ZacharyTurcotte/PMC-FrigorUS/README.md

# PMC-FrigorUS
code pour le projet de fin de bacc et les PCB
