ZacharyTurcotte/PMC-FrigorUS/PCB/Project Outputs for rasp_sheild/Report Board Stack/rasp_sheild.xls

Board Stack Report
Stack Up |  | Layer Stack
Layer | Board Layer Stack | Name | Material | Thickness | Constant
1 |  | Top Paste
2 |  | Top Overlay
3 |  | Top Solder | Solder Resist | 0.40mil | 3.5
4 |  | Top | Copper | 1.38mil
5 |  | Dielectric 3 |  | 62.99mil | 4.2
6 |  | Bottom | Copper | 1.38mil
7 |  | Bottom Solder | Solder Resist | 0.40mil | 3.5
8 |  | Bottom Overlay
9 |  | Bottom Paste
 | Height : 66.55mil
