ZacharyTurcotte/PMC-FrigorUS/PCB/Project Outputs for rasp_sheild/BOM/BOM-rasp_sheild.xlsx

Designator | Footprint | LibRef | Quantity | Value | Supplier Part Number 1
D2 | SMCJ36CA | SMCJ36CA | 1 |  | SMCJ36CABCT-ND
MH1, MH2, MH3, MH4 | MH2.75mm | MH2.75mm | 4
MH5, MH6, MH7 | MH3.2mm | MH3.2mm | 3
BT1 | 1058TR | 1058TR | 1 |  | 36-1058CT-ND
U5 | 8-SOIC | SN65HVD230QDR | 1 |  | 296-39176-1-ND
R1, R2, R3, R4, R5, R6, R7, R8, R9, R10, R11, R12, R13, R14, R15, R16, R17, R18, R19, R20, R21, R22, R23, R24, R25, R26, R27, R28, R29, R30, R31, R32, R33, R34, R35, R36, R37, R38, R39, R40, R41, R42, R43, R44, R45, R46, R47, R48, R49, R50, R51, R52, R53, R54, R55, R56, R57, R58, R59, R60 | RES_0603 | RES_0603 | 60 | 1k, 10k, 120 | 311-1.00KHRCT-ND
C3, C4, C5, C6, C7, C8, C9, C10, C11, C12, C14, C15, C16, C17, C18, C19, C20, C21, C22, C23, C24, C25, C26, C27, C28, C29 | CAP_0603 | CAP_0603 | 26 | 1uF, 0.1uF, 135pF, 22pF | 399-C0603C105K8RAC7867CT-ND
F1 | RES_0603 | F0603E1R75FSTR | 1 | 1.75A | 478-2865-1-ND
Y2 | ABLS-12.000MHZ-B4-T | ABLS-12.000MHZ-B4-T | 1 |  | 535-10218-1-ND
D1 | DO-214 | CDBA240LL-HF | 1 |  | 641-1698-6-ND
Y1 | SC32S-7PF20PPM | SC32S-7PF20PPM | 1 |  | 728-1074-1-ND
D5, D6, D7, D8 | LED 0603 | 150060SS75000 | 4 |  | 732-4979-1-ND
J4 | 61300311121 | 61300311121 | 1 |  | 732-5316-ND
J3, J6 | 691137710002 | 691137710002 | 2 |  | 732-10955-ND
C2, C13, C30 | CAP_0603 | CAP_0603 | 3 | 22uF, 0.1uF | 1276-1274-1-ND
C1 | CAP_1210 | CAP_1210 | 1 | 10uF | 1276-3387-1-ND
J1 | PRT-16764 | PRT-14275_1 | 1 |  | 1568-PRT-16764-ND
D4 | SOT-23-3 | PMEG2005CT,215 | 1 |  | 1727-5188-1-ND
PS1 | CONV_K7805-3AR3 | K7805-3AR3 | 1 |  | 2725-K7805-3AR3-ND
D3 | SOT-23-3 | PJEC12VM1TA-AU_R1_000A1 | 1 |  | 3757-PJEC12VM1TA-AU_R1_000A1DKR-ND
U1, U7, U8, U9 | D3V3F8U9LP3810-7 | D3V3F8U9LP3810-7 | 4 |  | D3V3F8U9LP3810-7DICT-ND
U2 | 24-QSSOP | MAX11625EEG+ | 1 |  | MAX11625EEG+-ND
U6 | 18-SOIC | MCP2515-I/SO | 1 |  | MCP2515-I/SO-ND
U3 | 28-SOIC | MCP23017T-E/SO | 1 |  | MCP23017T-E/SOCT-ND
U4 | 8-MSOP | PCA85073ADP/Q900Z | 1 |  | PCA85073ADP/Q900Z
J9 | 0430450400 | 0430450400 | 1 |  | WM1814-ND
J2, J5, J7, J8 | 0430451600 | 0430451600 | 4 |  | WM4724-ND
 |  |  | 11 |  | 311-10.0KHRCT-ND
 |  |  | 11 |  | P120DBCT-ND
 |  |  | 11 |  | 478-7939-1-ND
 |  |  | 11 |  | 399-15378-1-ND
