ZacharyTurcotte/PMC-FrigorUS/thermistance_arduino/python_read_serial/test_frigo.csv

N | Thermistor 0 | Thermistor 1 | Thermistor 2 | Thermistor 3 | Thermistor 4
0 | 18.86 | 16.05 | 14.46 | 13.66 | 22.74
1 | 19.65 | 17.02 | 15.43 | 14.64 | 22.74
2 | 19.74 | 17.02 | 15.26 | 14.28 | 22.74
3 | 19.48 | 16.67 | 14.99 | 14.19 | 22.74
4 | 19.83 | 17.20 | 15.61 | 14.72 | 22.74
5 | 19.65 | 16.84 | 15.08 | 14.10 | 22.74
6 | 19.48 | 16.84 | 15.26 | 14.46 | 22.74
7 | 19.83 | 17.28 | 15.61 | 14.64 | 22.74
8 | 19.48 | 16.76 | 14.99 | 14.01 | 22.65
9 | 19.65 | 17.11 | 15.52 | 14.72 | 22.65
