ZacharyTurcotte/PMC-FrigorUS/PCB/rasp_sheild.pdf

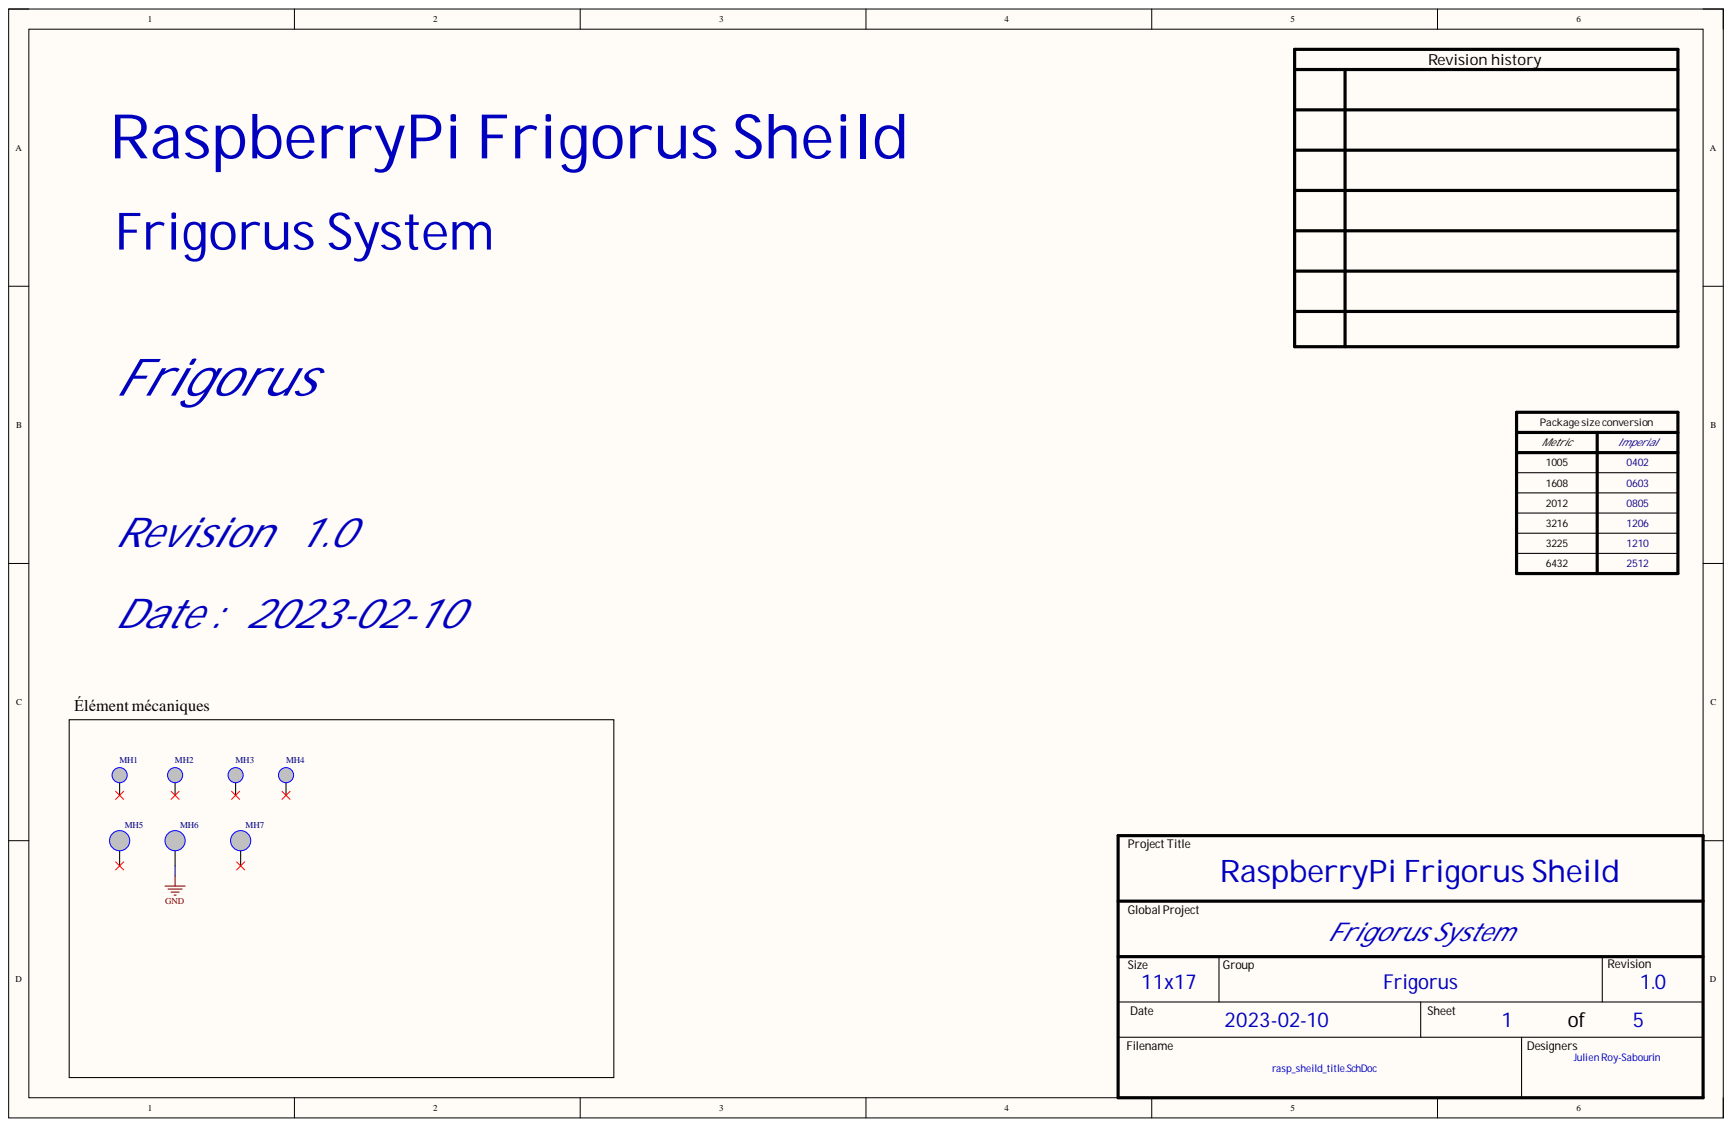
[picture p1: page 1]

Metric | Imperial
1005 | 0402
1608 | 0603
2012 | 0805
3216 | 1206
3225 | 1210
6432 | 2512

Size 11x17 | Group Frigorus | Revision 1.0

Date 2023-02-10 | Sheet of 1 5

Filename rasp_sheild_title.SchDoc | Designers Julien Roy-Sabourin

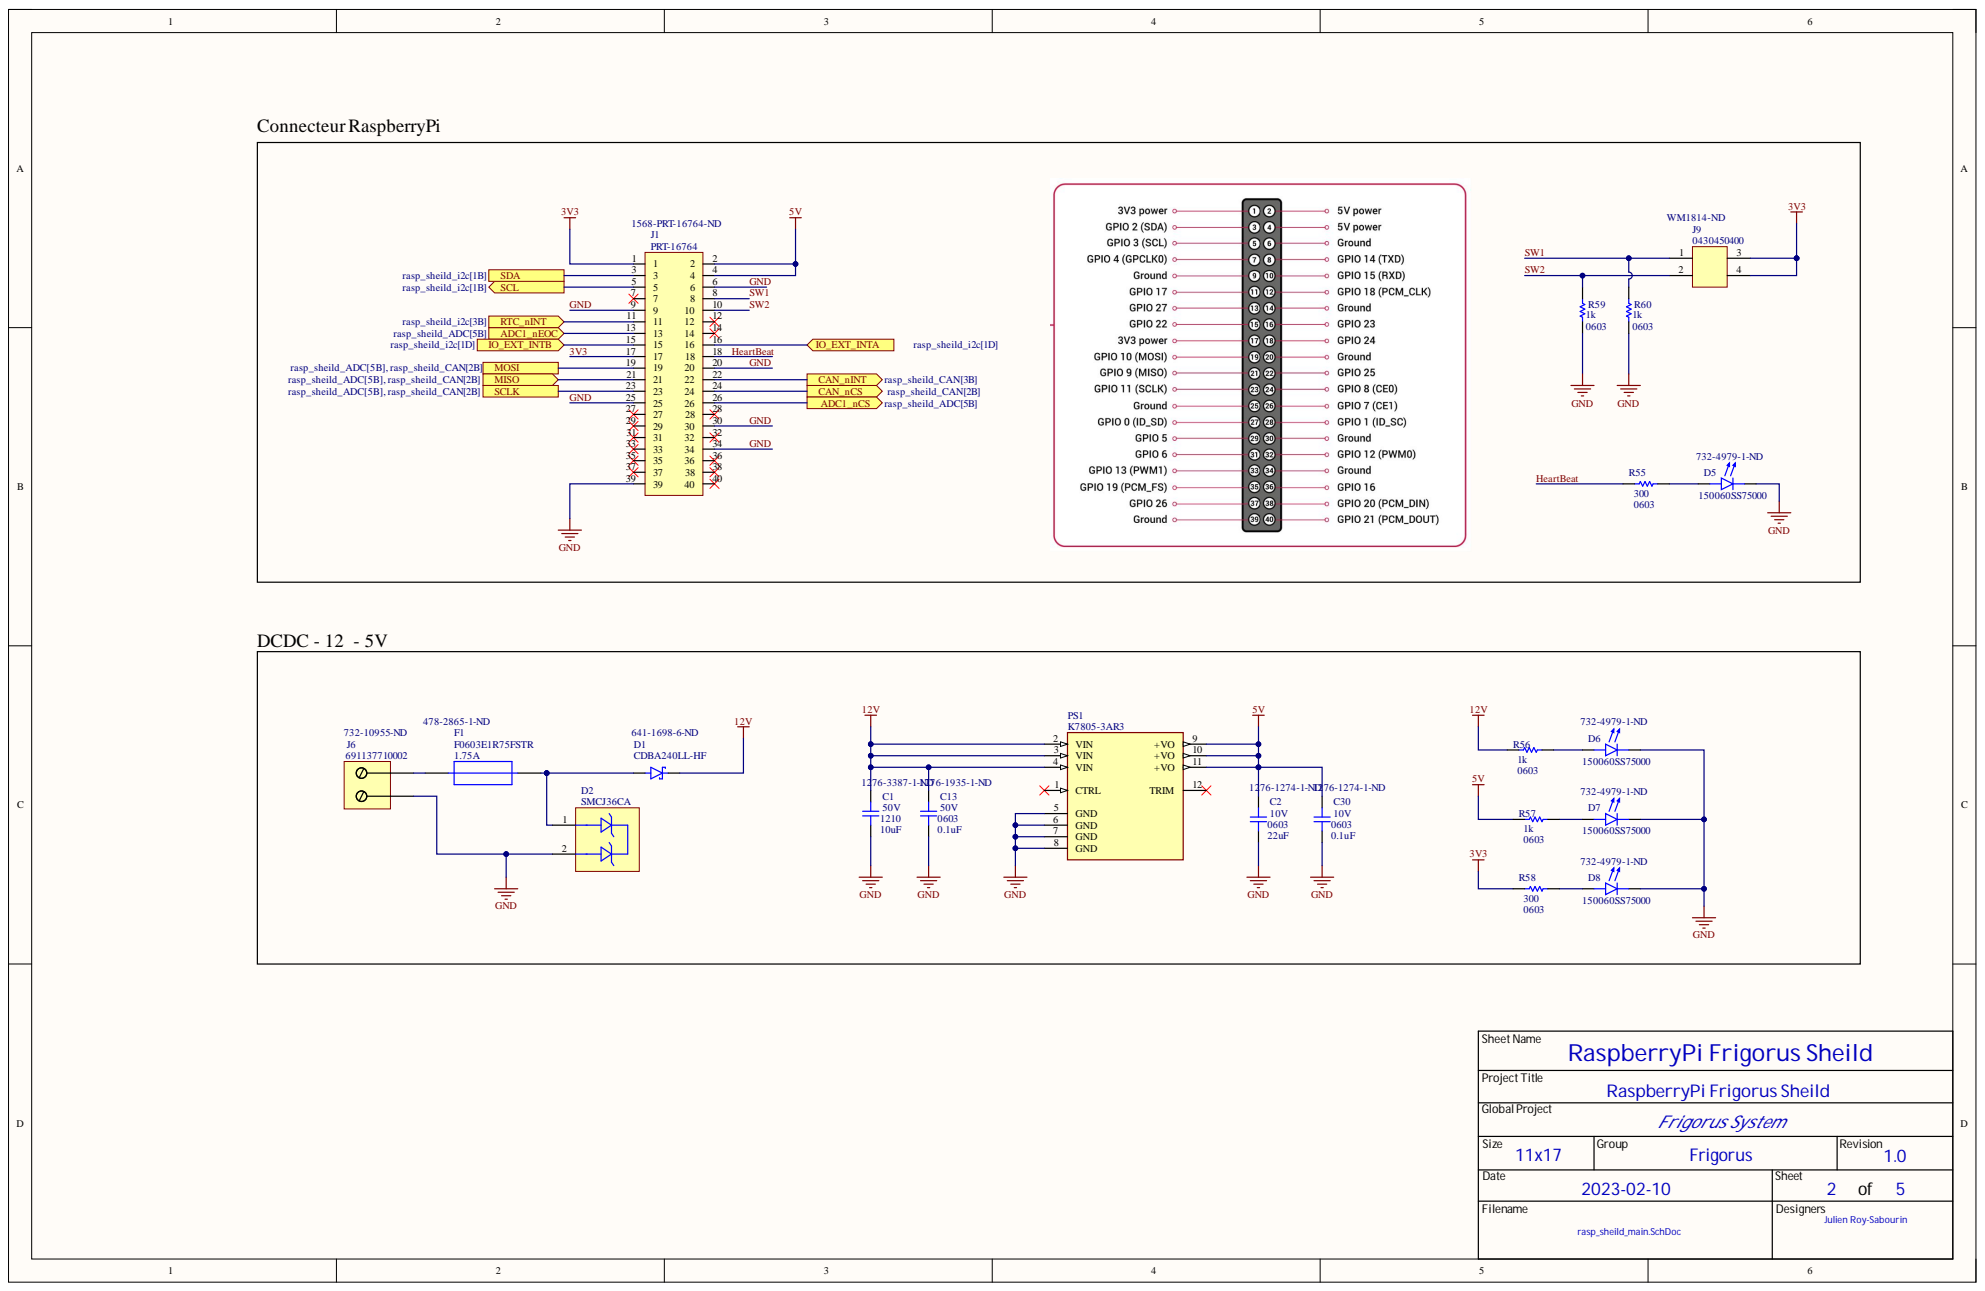
[picture p2: page 2]

VIN 3

1276-3387-1-ND D2 | 1276-1935-1-ND | | CTRL 1 | 1276-1274-1-ND

Project Title
RaspberryPi Frigorus Sheild GlobalProject

Size 11x17 | Group Frigorus | Revision 1.0

Date 2023-02-10 | Sheet 2 of Designers 5

Filename rasp_sheild_main.SchDoc | Julien Roy-Sabourin

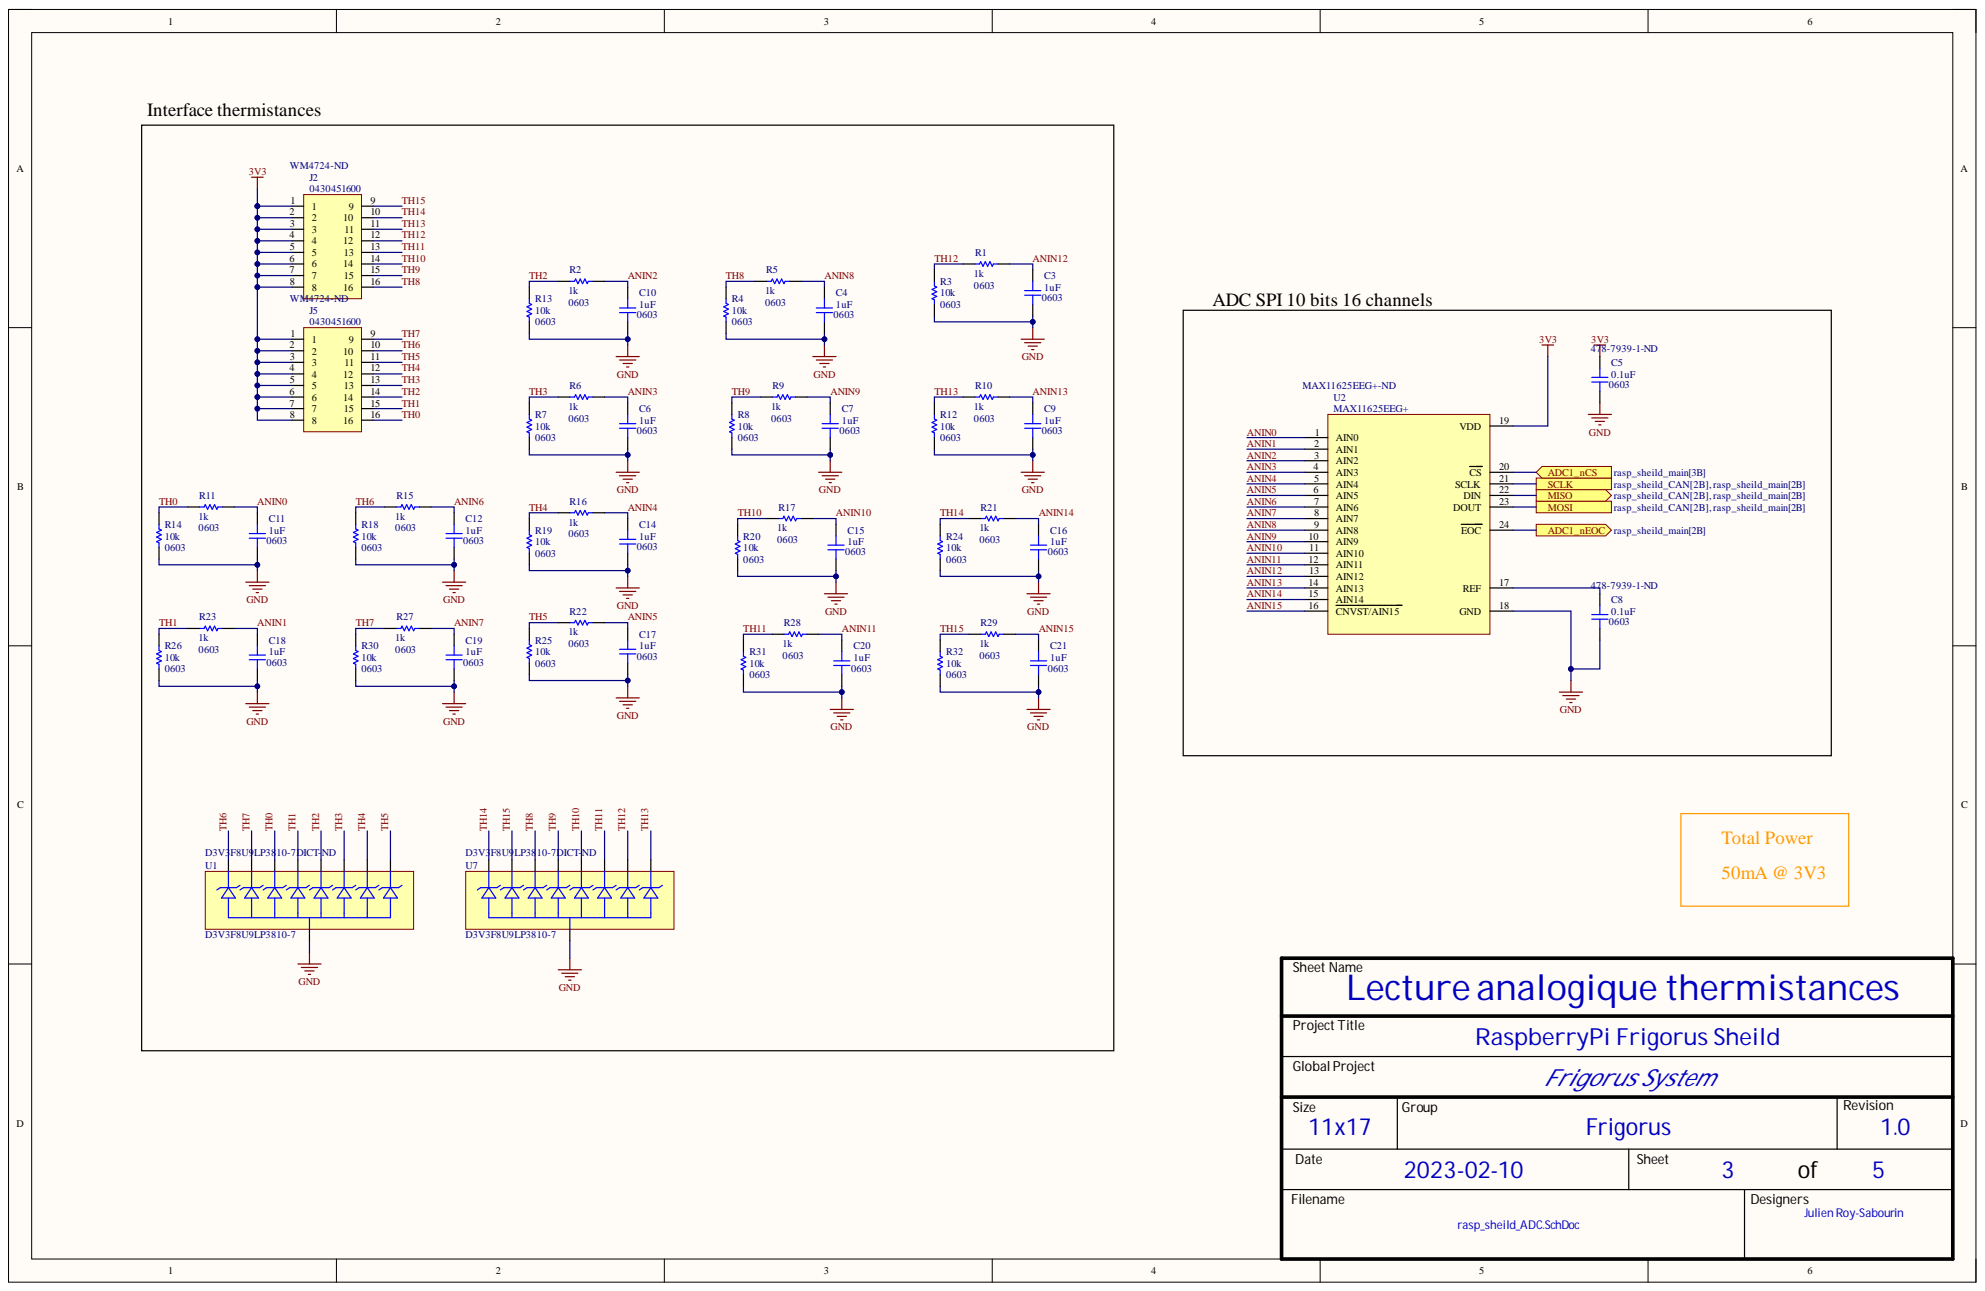
[picture p3: page 3]

ADC SPI 10 bits 16 channels

Size 11x17 | Group Frigorus | Revision 1.0

Date 2023-02-10 | Sheet of 3 5

Filename rasp_sheild_ADC.SchDoc | Designers Julien Roy-Sabourin

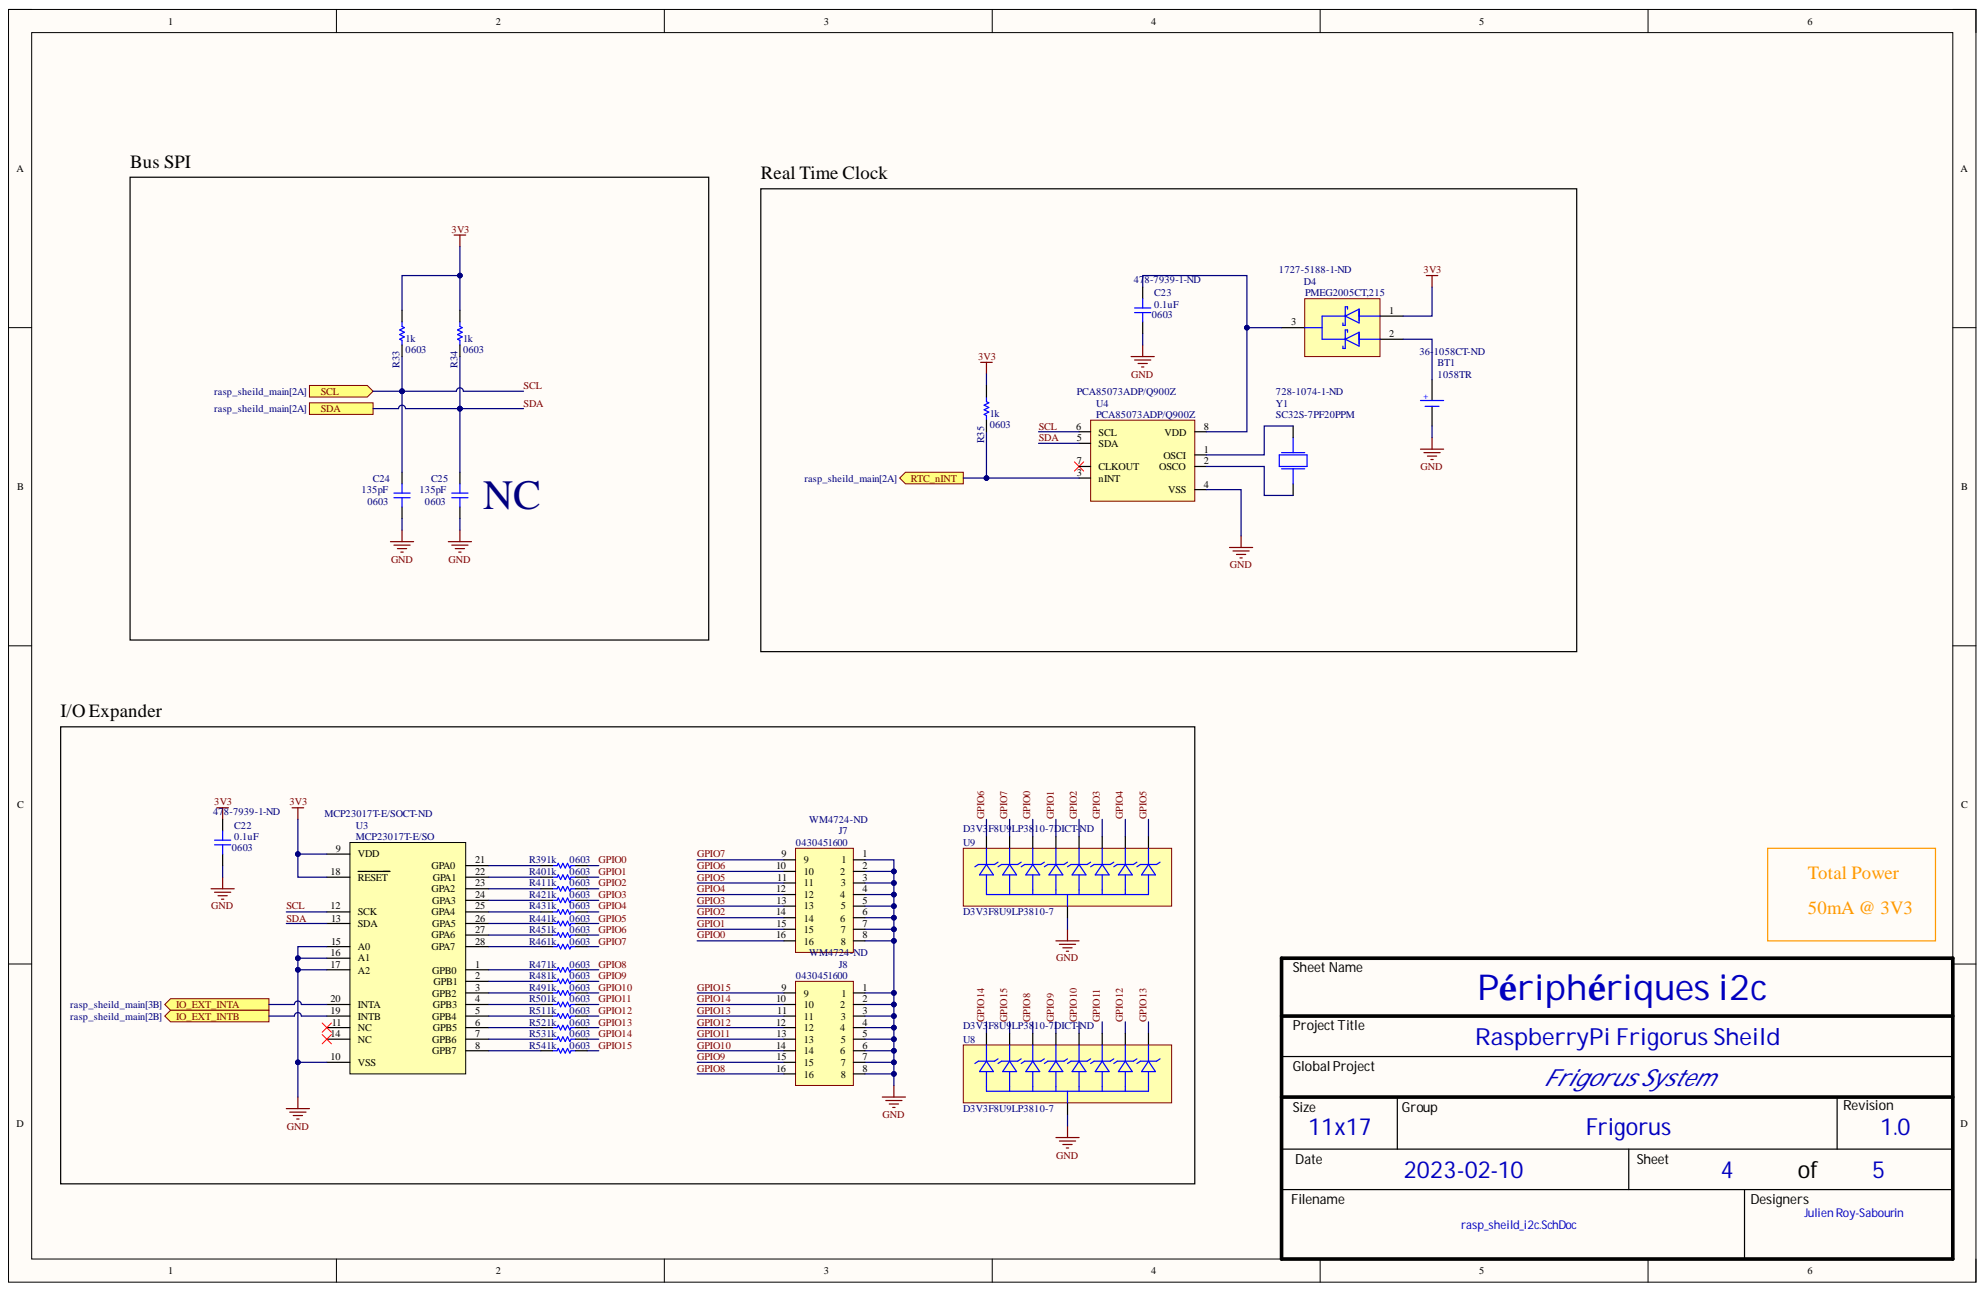
[picture p4: page 4]

Size 11x17 | Group Frigorus | Revision 1.0

Date 2023-02-10 | Sheet of 4 5

Filename rasp_sheild_i2c.SchDoc | Designers Julien Roy-Sabourin

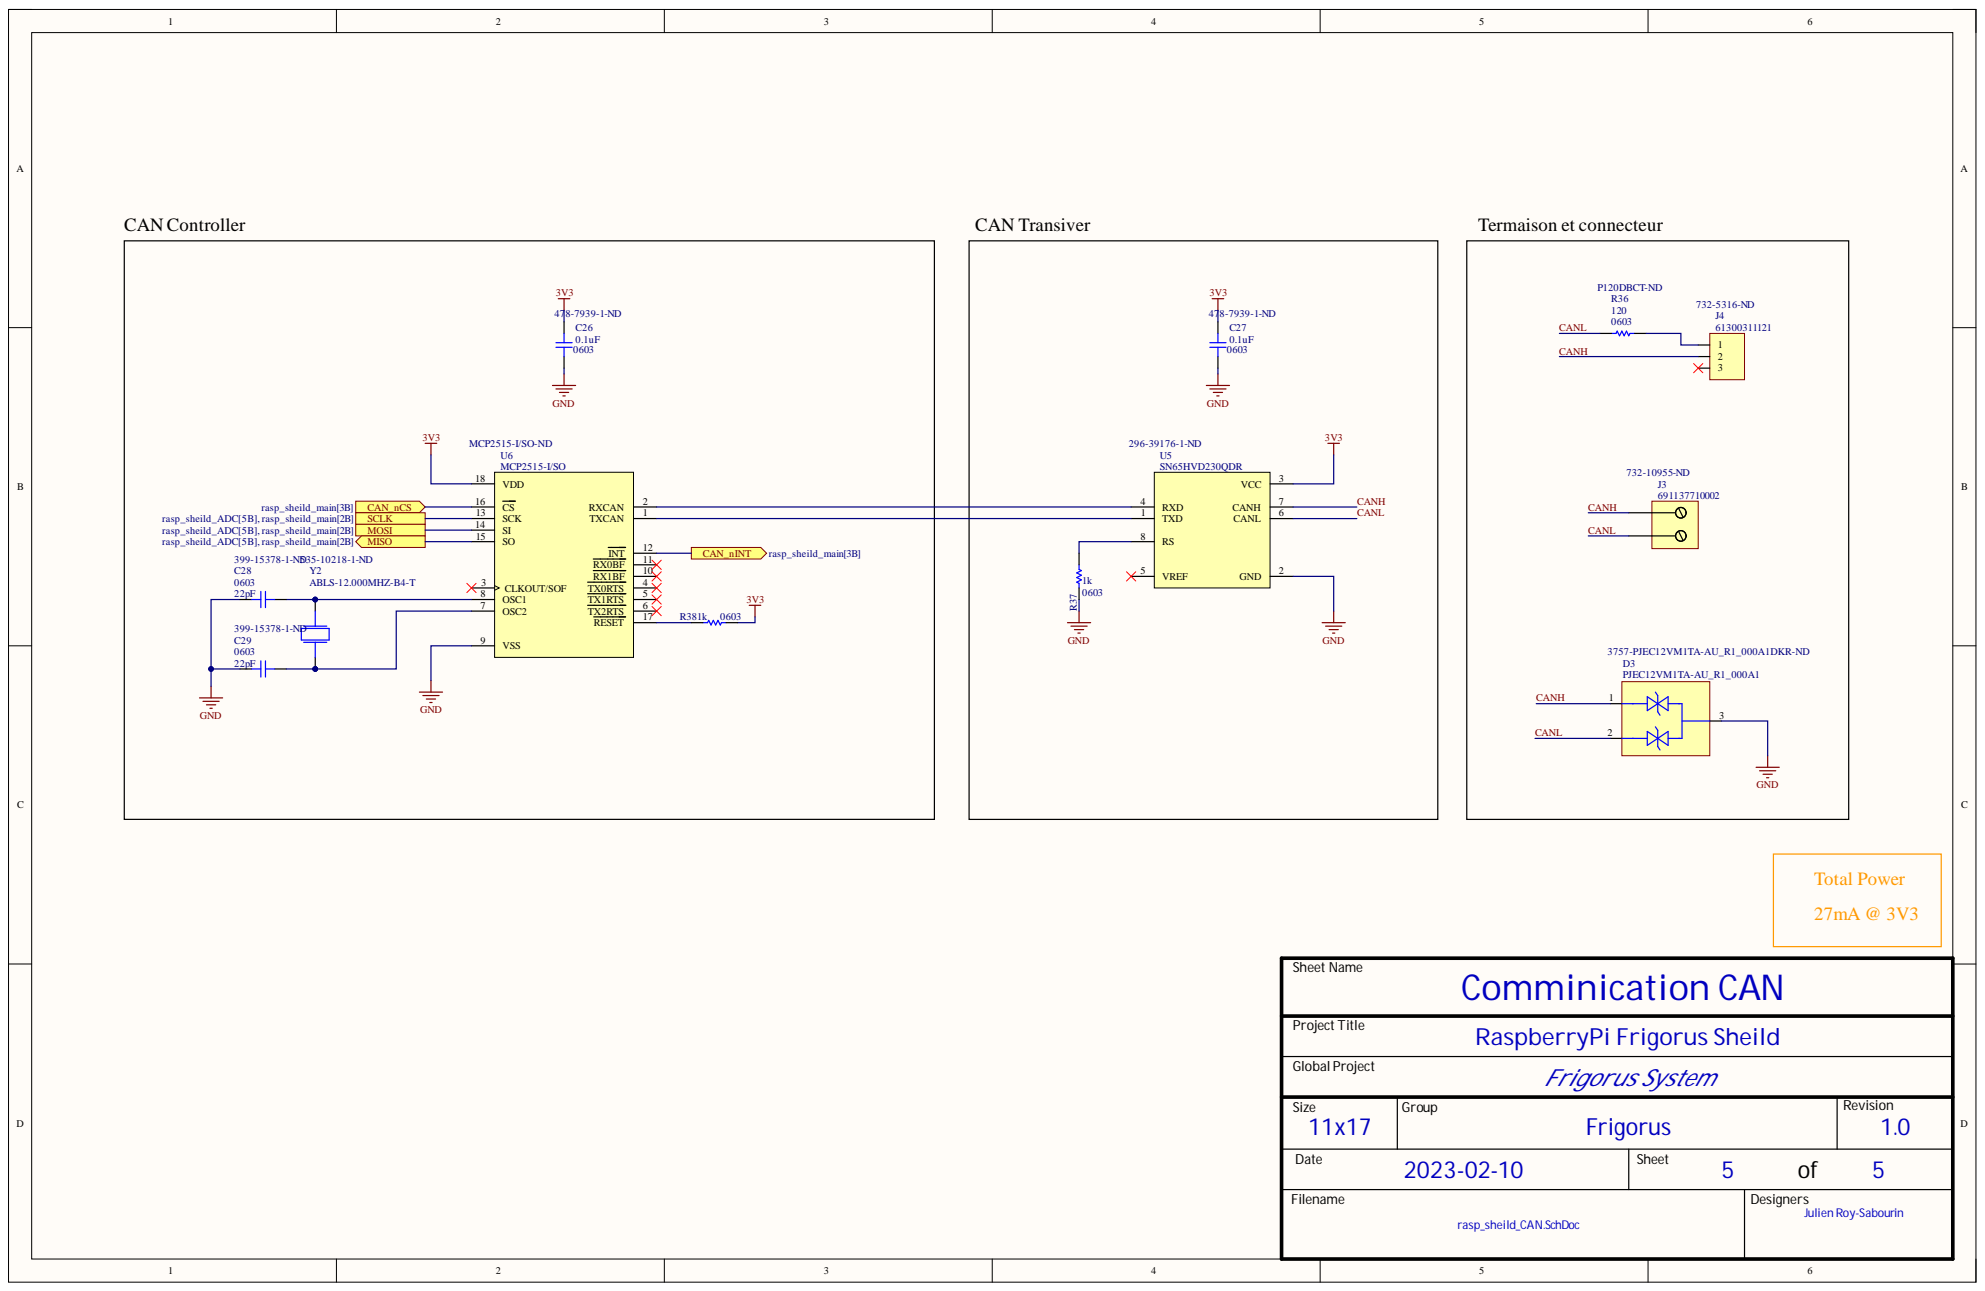
[picture p5: page 5]

S i z e 1 1x1 7 | Gr ou p Frigoru s | Rev ision 1 . 0

Date Filename 2 0 2 3-0 2 -1 0 | S heet of 5 5

r a sp_she i ld_CA N . Sch D oc | Desi gner s Jul i en R oy-Sabo u r i n
