ZacharyTurcotte/PMC-FrigorUS/PCB/pdf/rasp_sheild.pdf

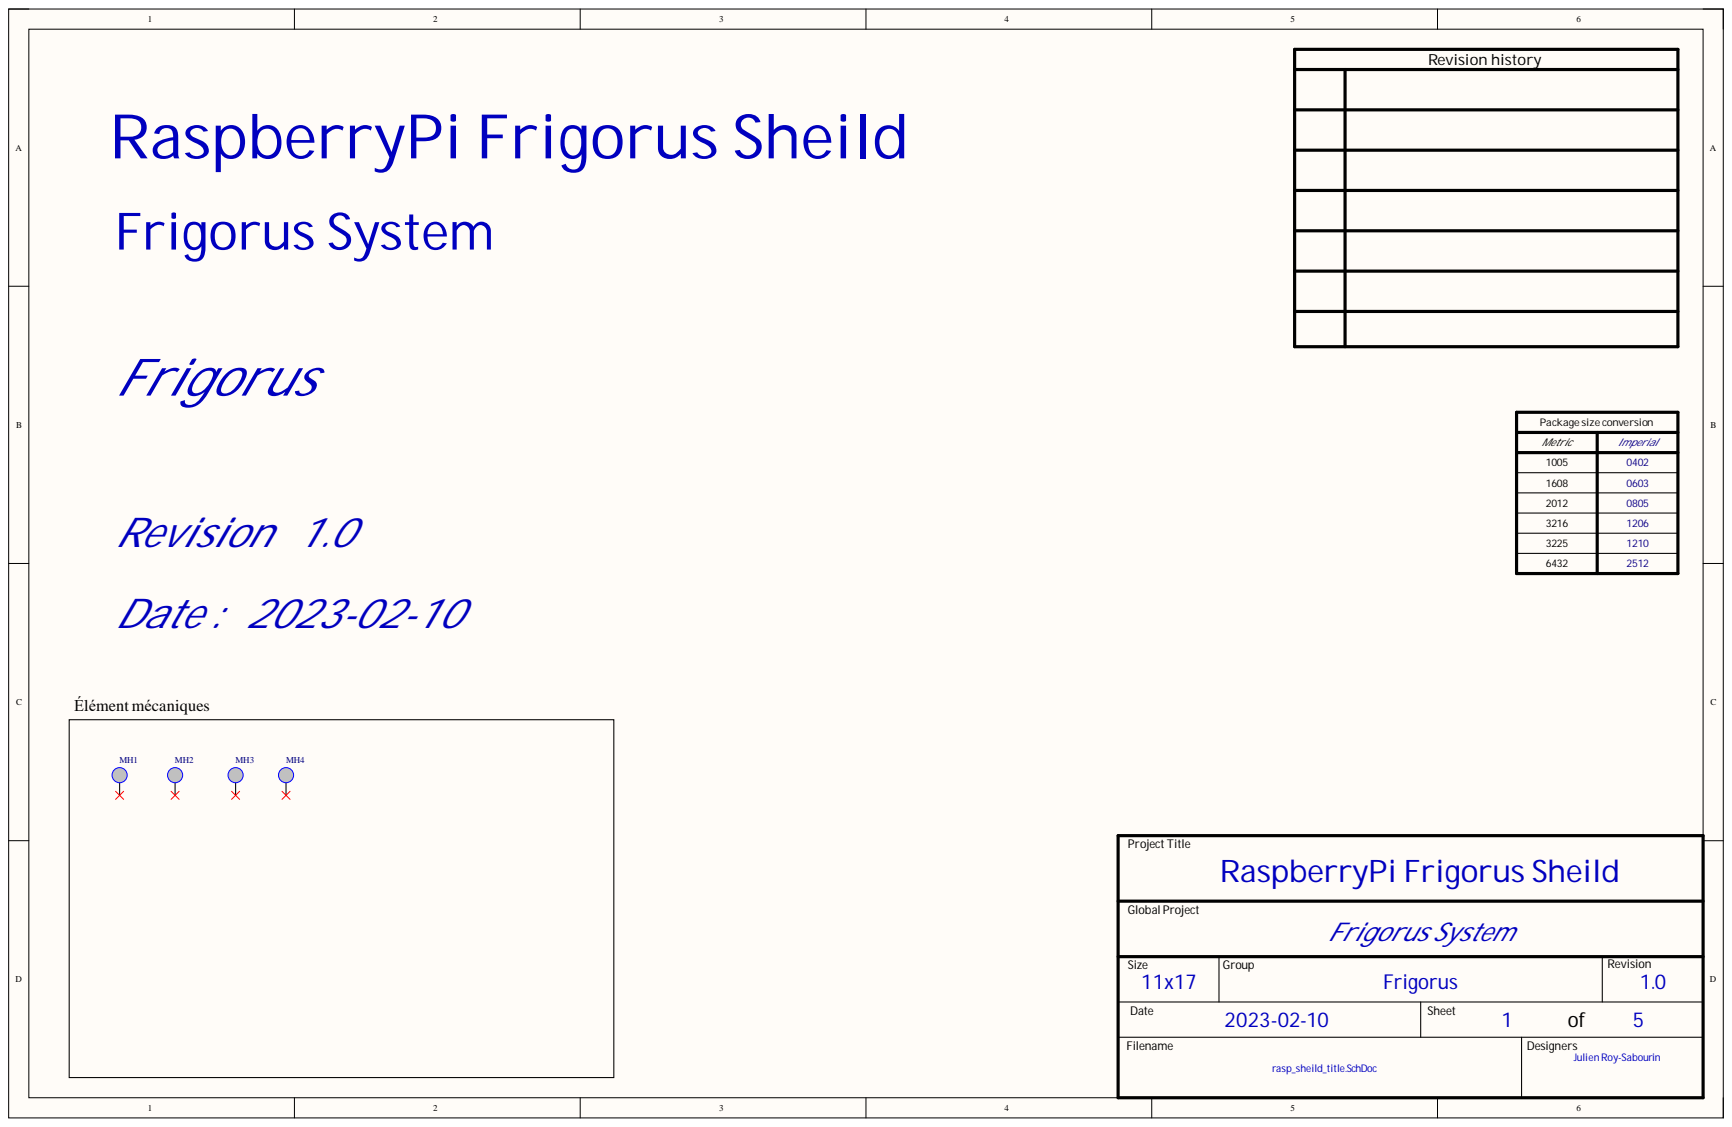
[picture p6: page 1]

RaspberryPi Frigorus Sheild Frigorus System Revision

Metric | Im peria l
100 5 | 040 2
160 8 | 060 3
201 2 | 080 5
321 6 | 120 6
322 5 | 121 0
643 2 | 251 2

S i z e 1 1x1 7 | Gr o u p Frigoru s | Rev ision 1 . 0

Date Filename 2 0 2 3-0 2 -1 0 | S heet of 1 5

r a sp_she i ld_t i t l e . S c h D o c | Desi gner s Jul i en R oy-Sabo u r i n

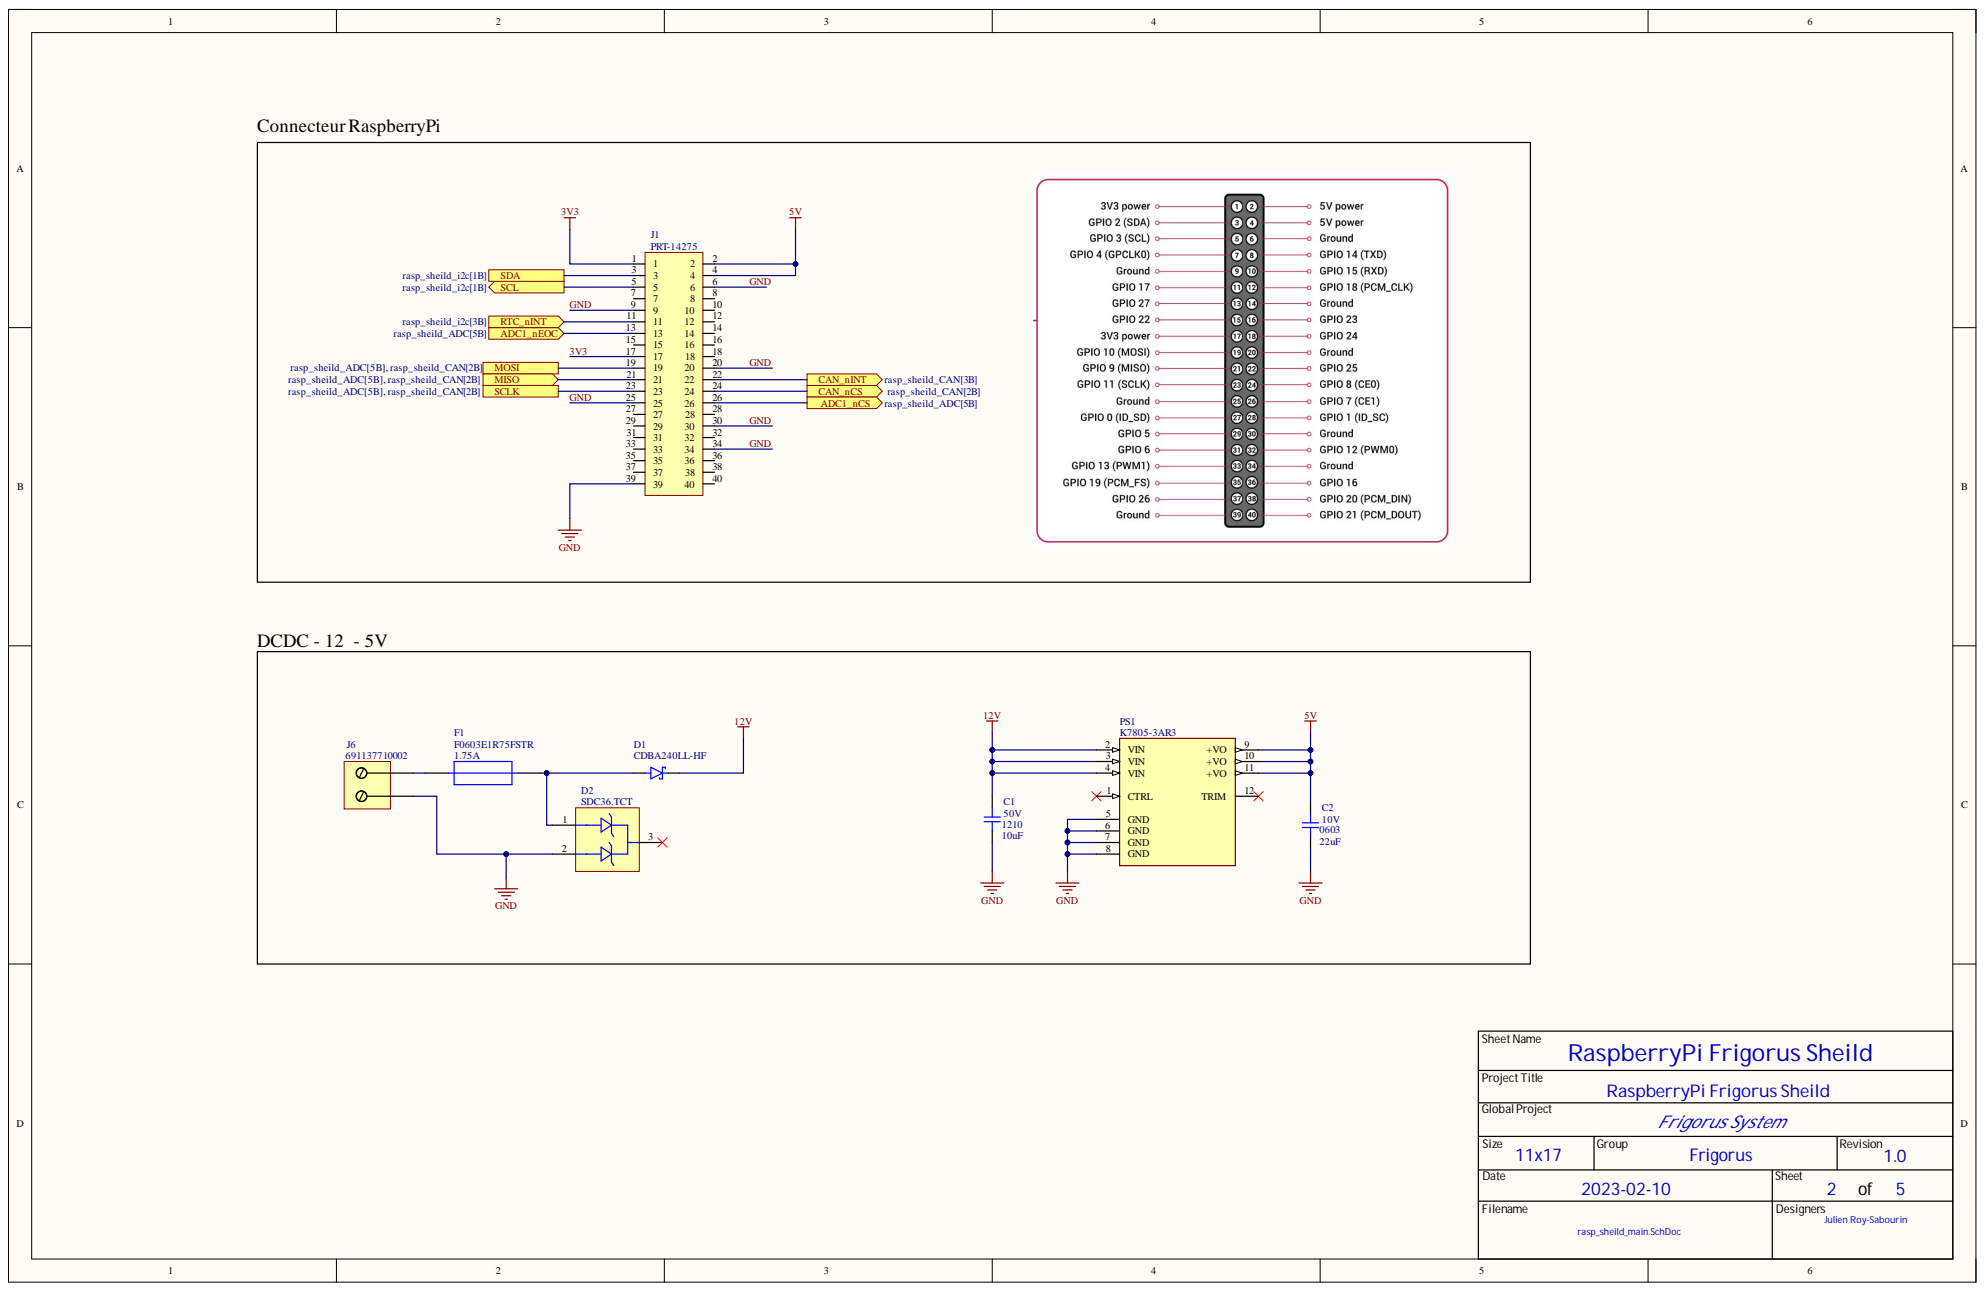
[picture p7: page 2]

Project Title
RaspberryPi Frigorus Sheild GlobalProject

Size 11x17 | Group Frigorus | Revision 1.0

Date 2023-02-10 | Sheet 2 of Designers 5

Filename rasp_sheild_main.SchDoc | Julien Roy-Sabourin

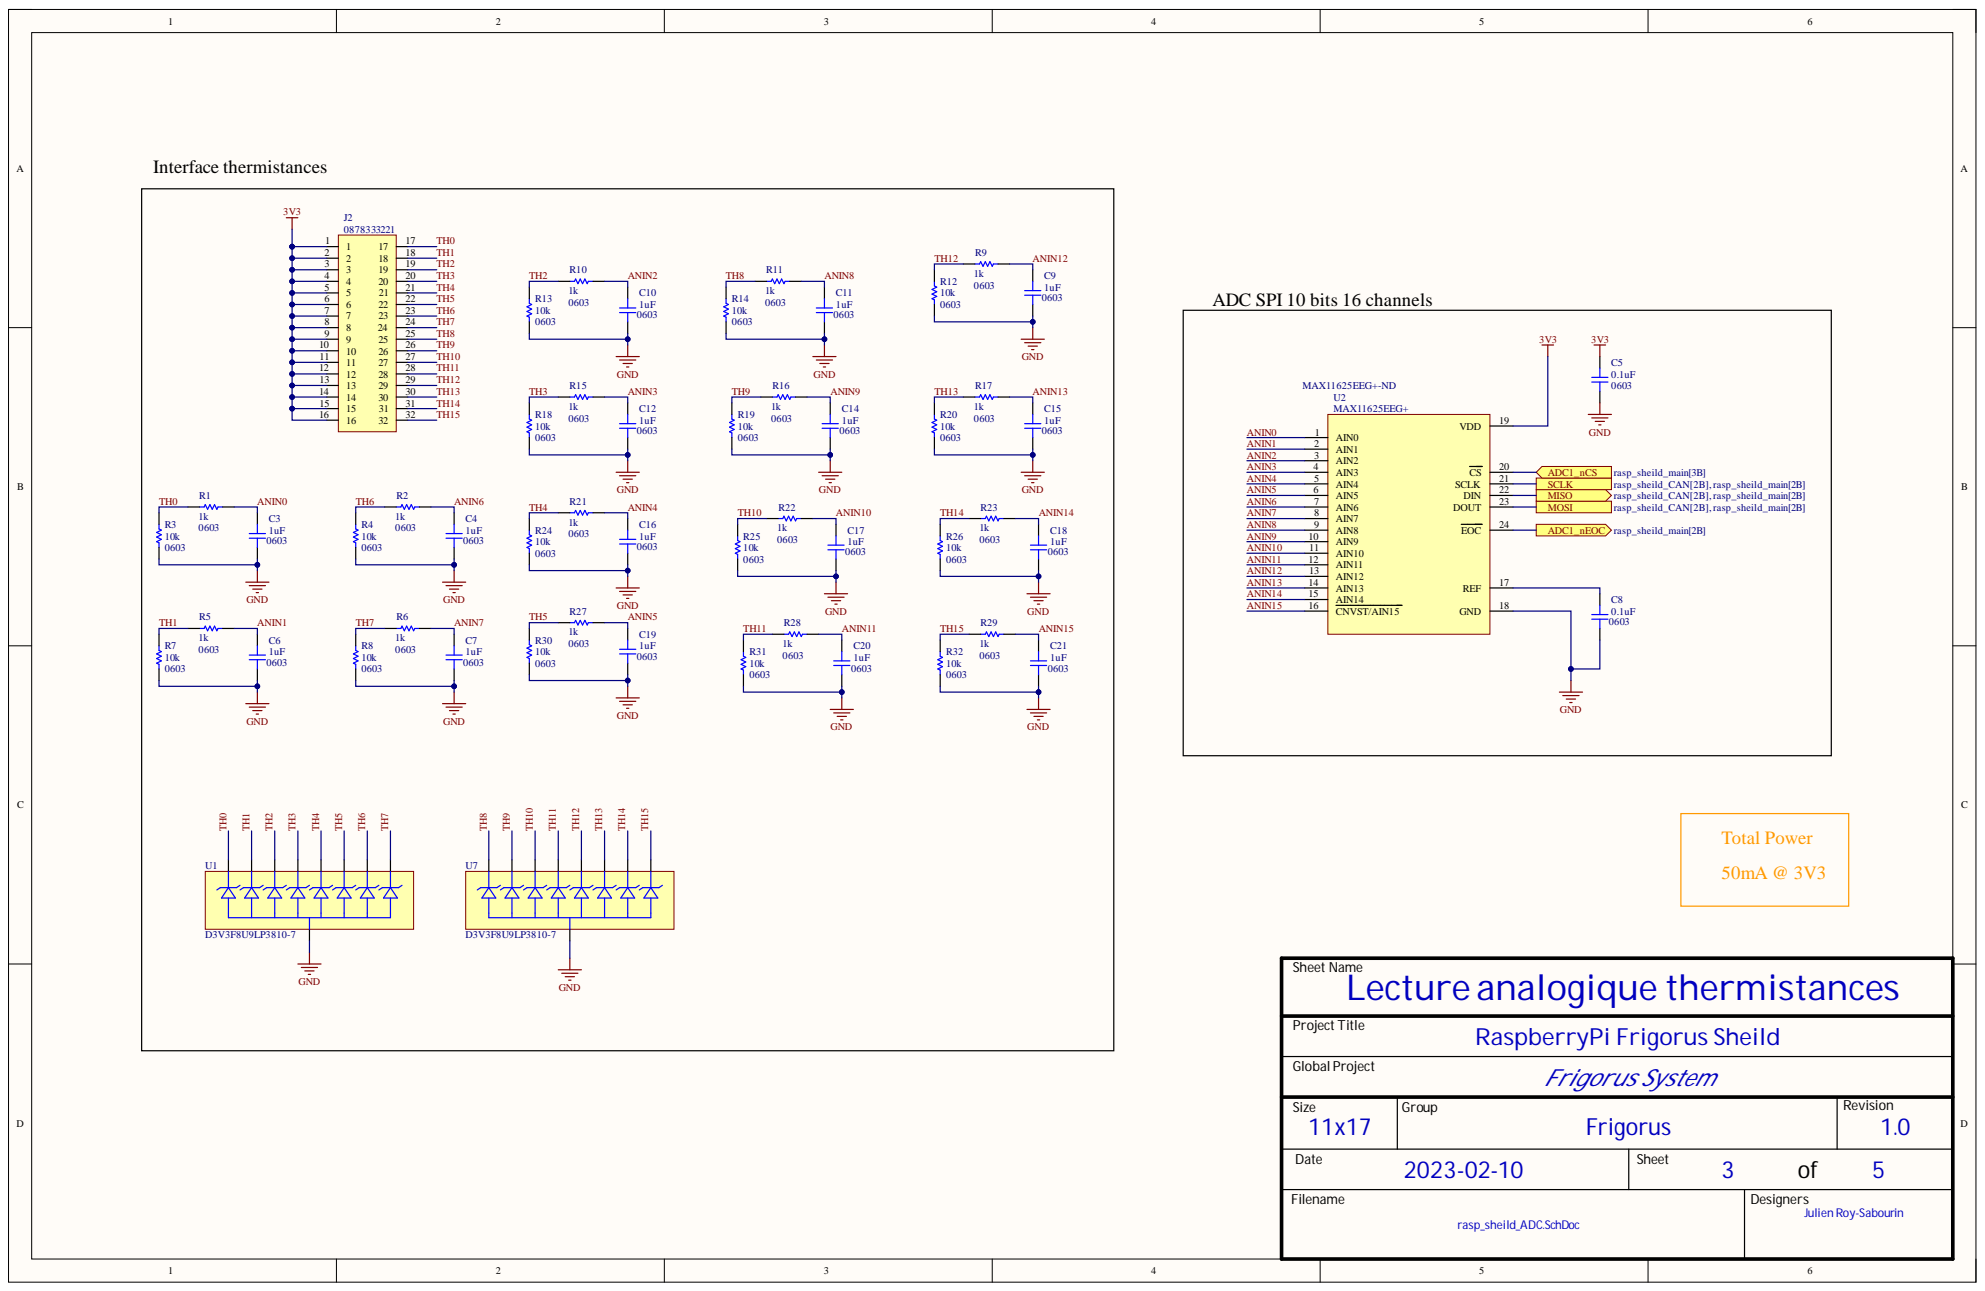
[picture p8: page 3]

ADC SPI 10 bits 16 channels

Size 11x17 | Group Frigorus | Revision 1.0

Date 2023-02-10 | Sheet of 3 5

Filename rasp_sheild_ADC.SchDoc | Designers Julien Roy-Sabourin

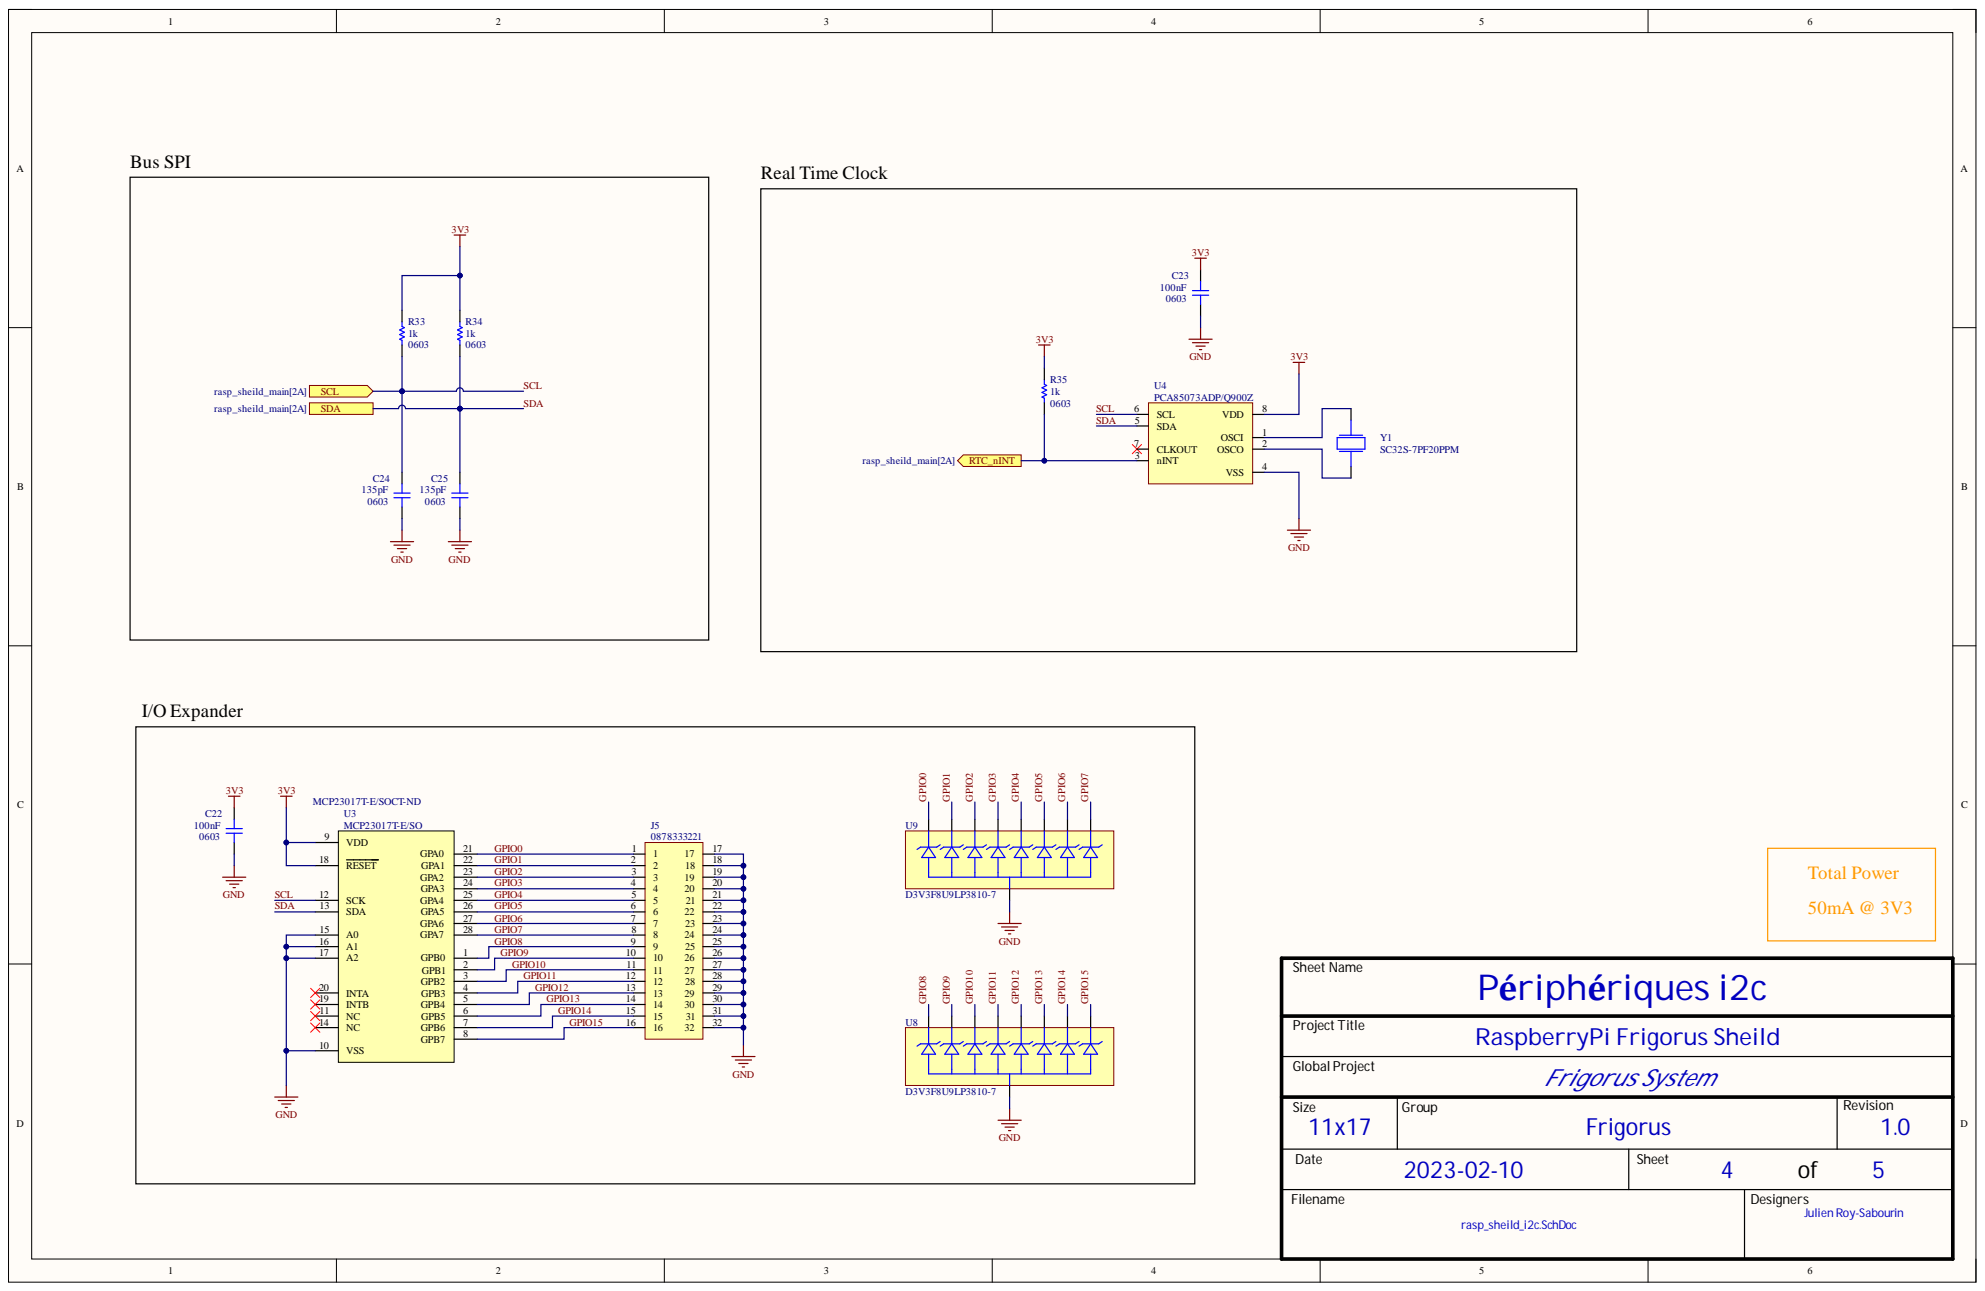
[picture p9: page 4]

Size 11x17 | Group Frigorus | Revision 1.0

Date 2023-02-10 | Sheet of 4 5

Filename rasp_sheild_i2c.SchDoc | Designers Julien Roy-Sabourin

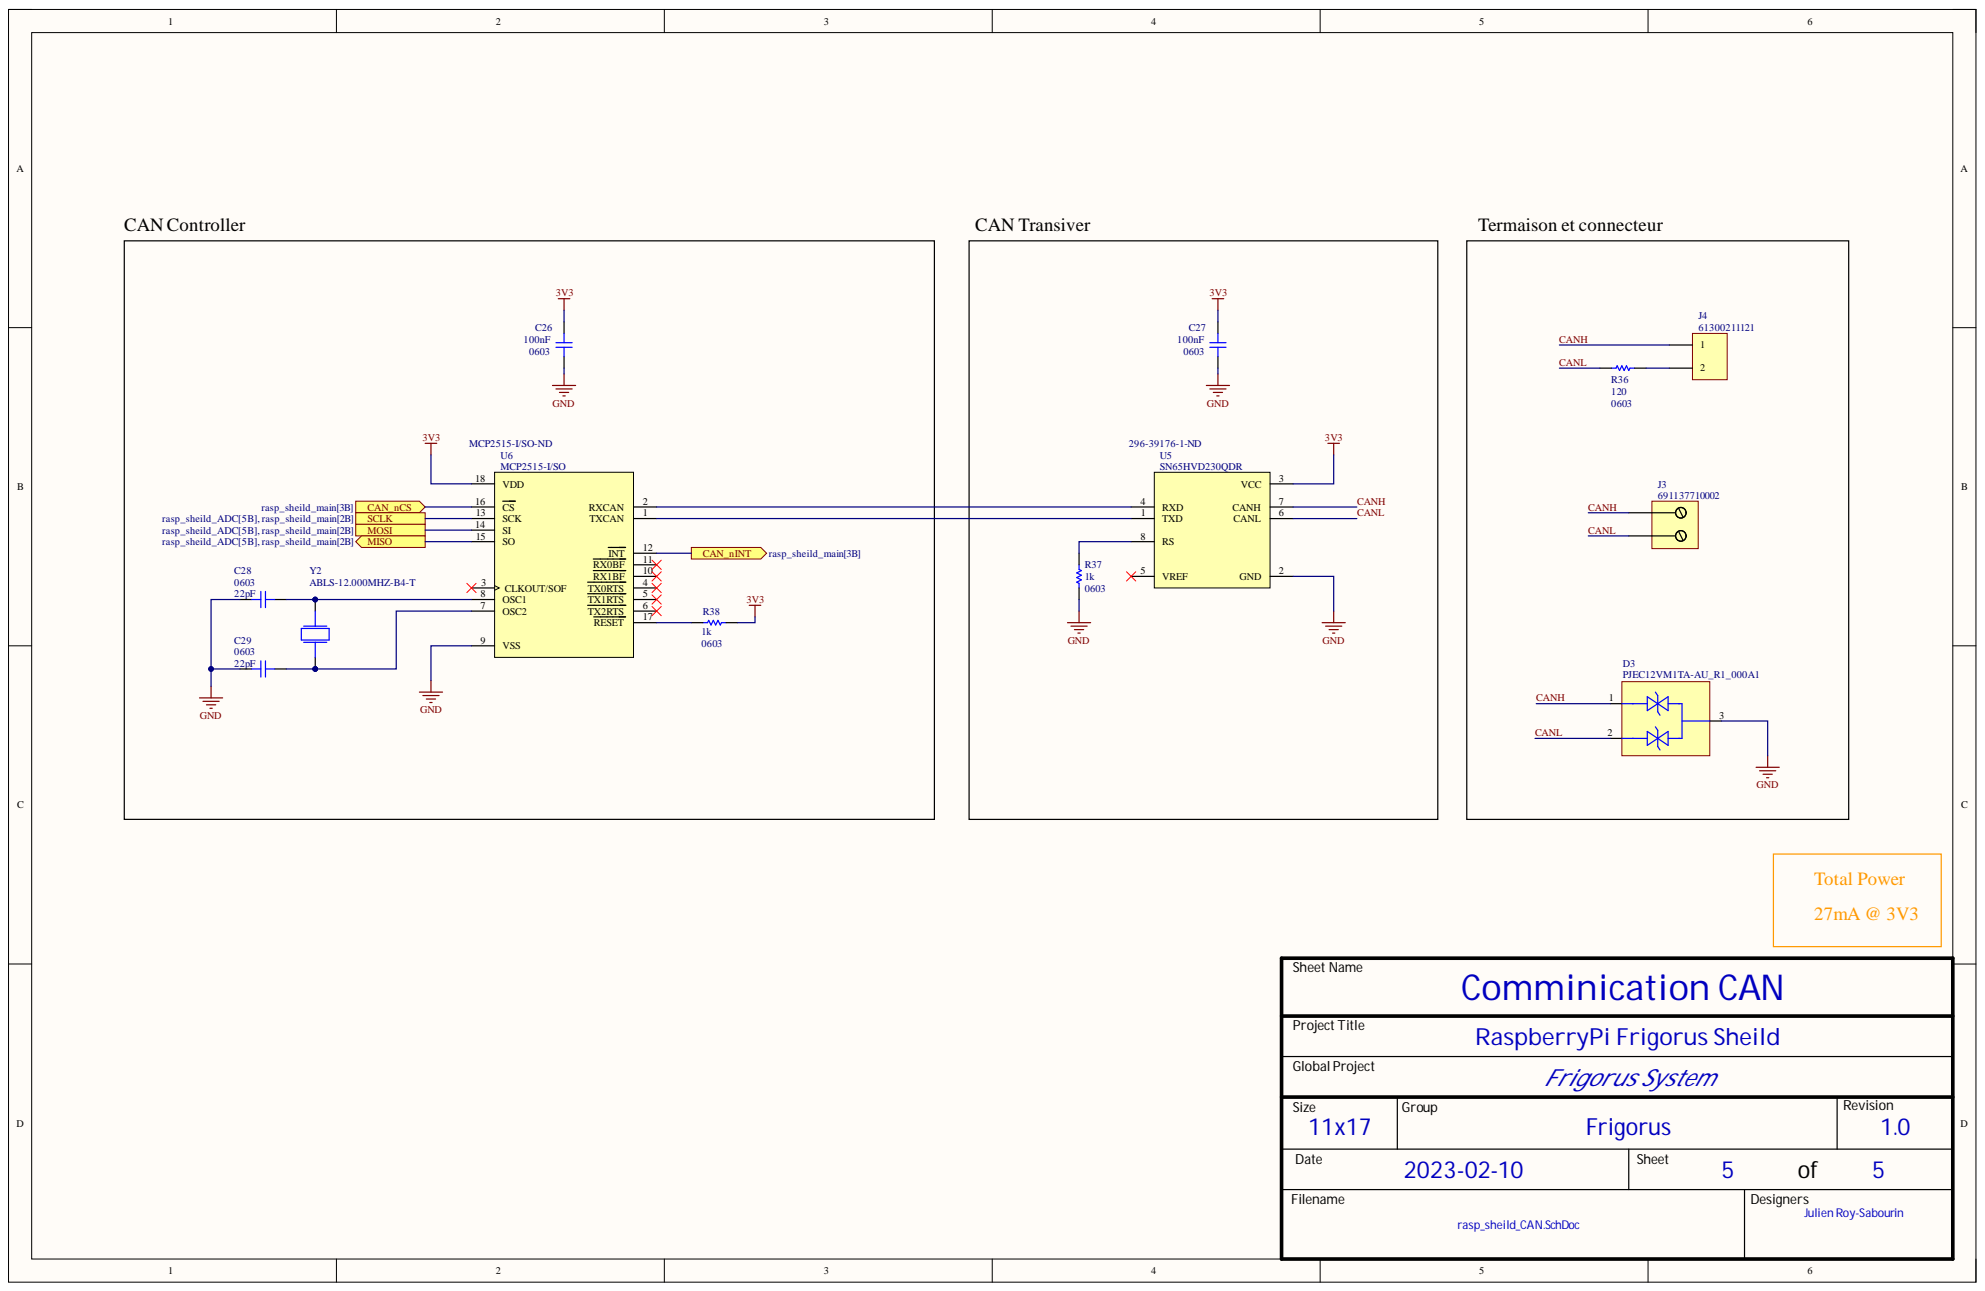
[picture p10: page 5]
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

Date Filename 2 0 2 3-0 2 -1 0 | S heet of 5 5

r a sp_she i ld_C A N . S c h D o c | Desi gner s Jul i en R oy-Sabo u r i n
