ZacharyTurcotte/PMC-FrigorUS/PCB/pdf/rasp_sheild_revEL.pdf

RaspberryPi Frigorus Sheild Frigorus System Revision

Metric | Im peria l
1005 | 0402
1608 | 0603
201 2 | 0805
321 6 | 1206
322 5 | 121 0
643 2 | 251 2

S i z e 1 1x1 7 | Gr ou p Frigoru s | Rev ision 1 . 0

Date Filename 2 0 2 3-0 2 -1 0 | S heet of 1 5

r a sp_she i ld_t i t l e . Sch D oc | Desi gner s Jul i en R oy-Sabo u r i n

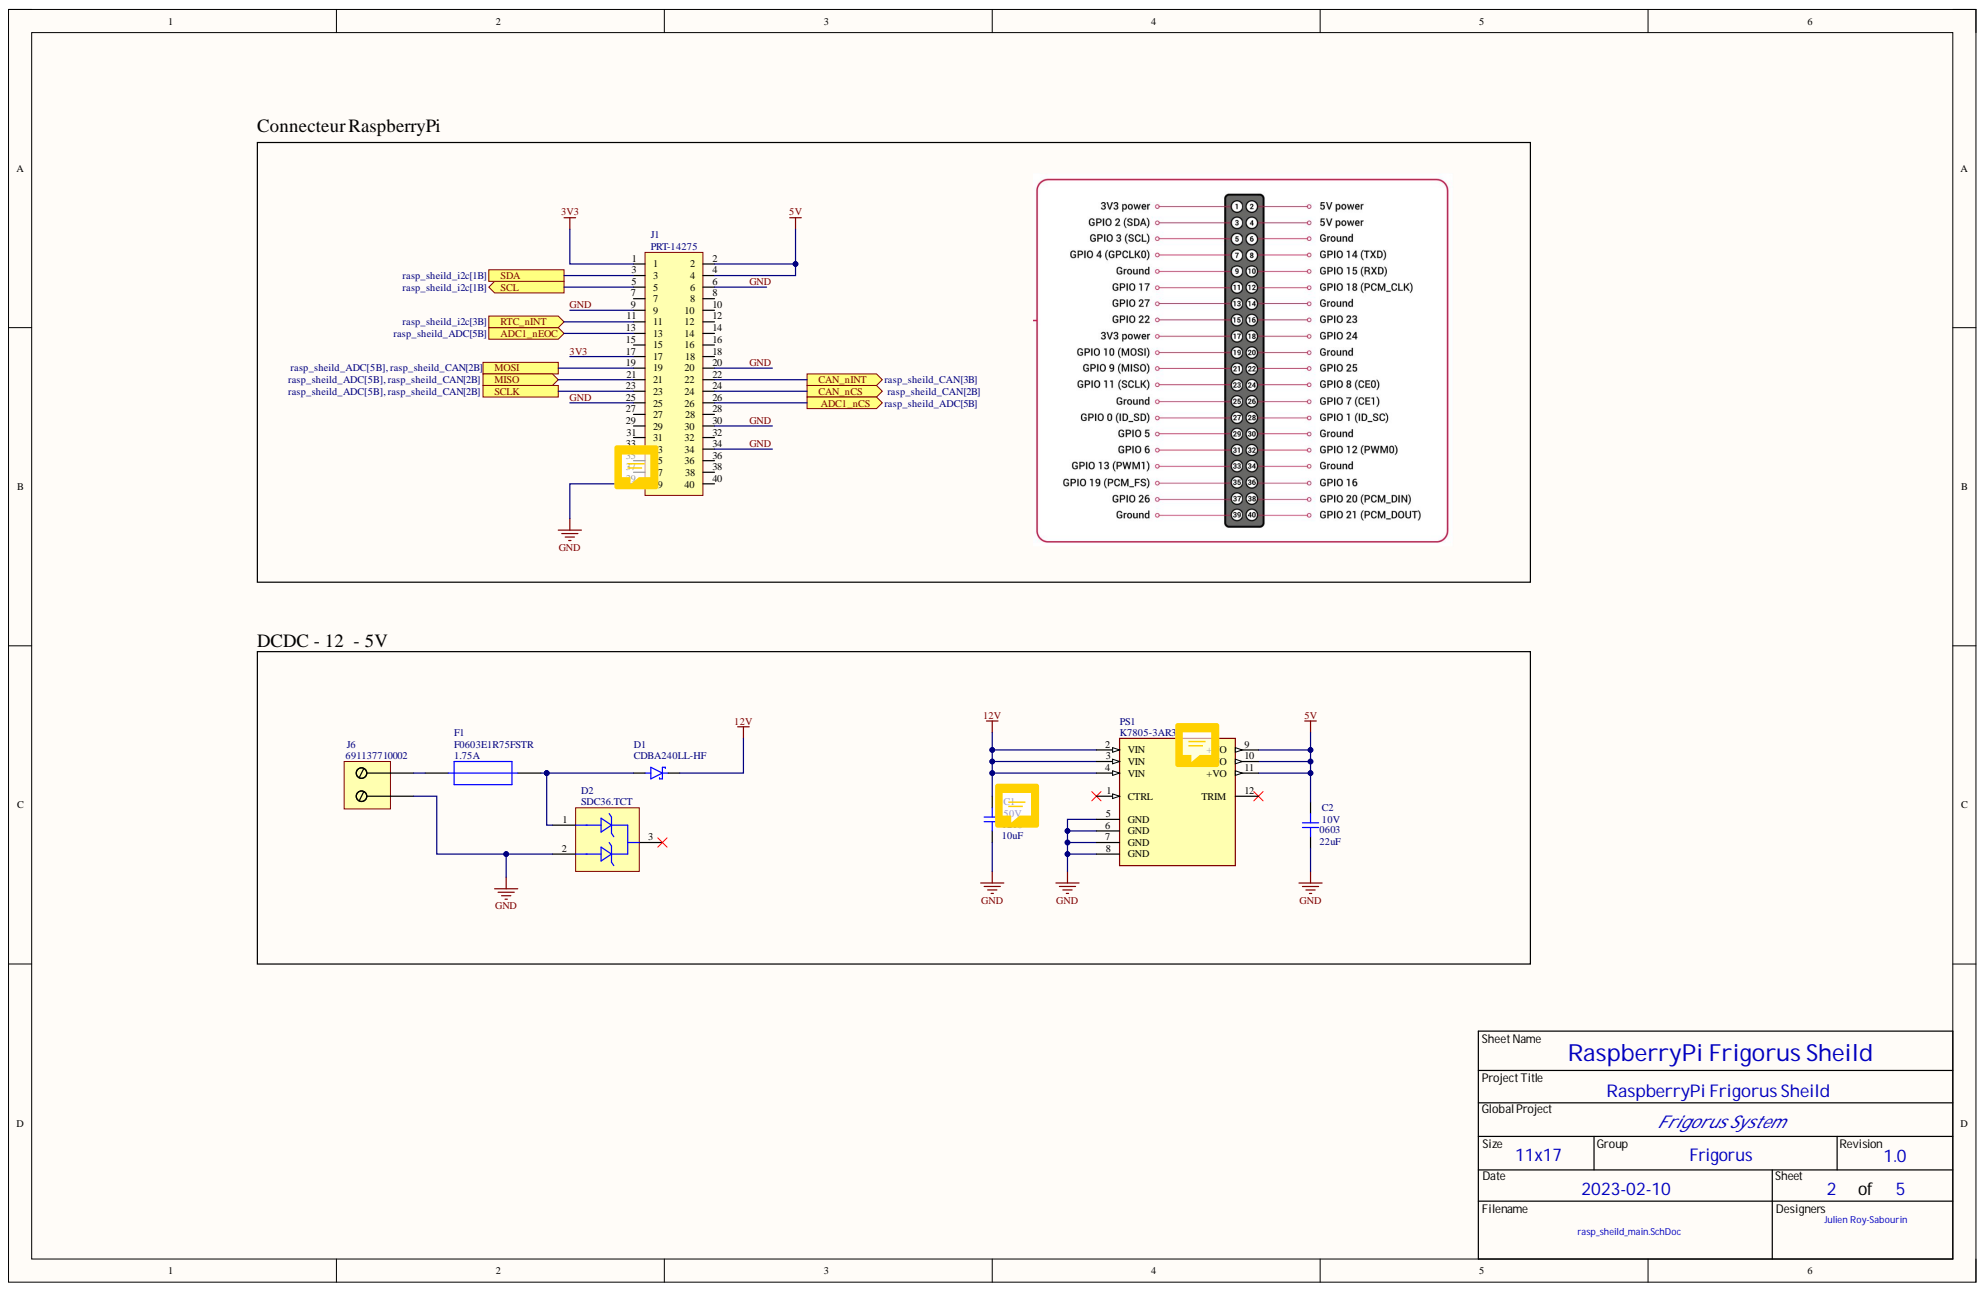
[picture p11: page 2]

Project Title
RaspberryPi Frigorus Sheild GlobalProject

Size 11x17 | Group Frigorus | Revision 1.0

Date 2023-02-10 | Sheet 2 of Designers 5

Filename rasp_sheild_main.SchDoc | Julien Roy-Sabourin


ADC SPI 10 bits 16 channels

Size 11x17 | Group Frigorus | Revision 1.0

Date 2023-02-10 | Sheet of 3 5

Filename rasp_sheild_ADC.SchDoc | Designers Julien Roy-Sabourin

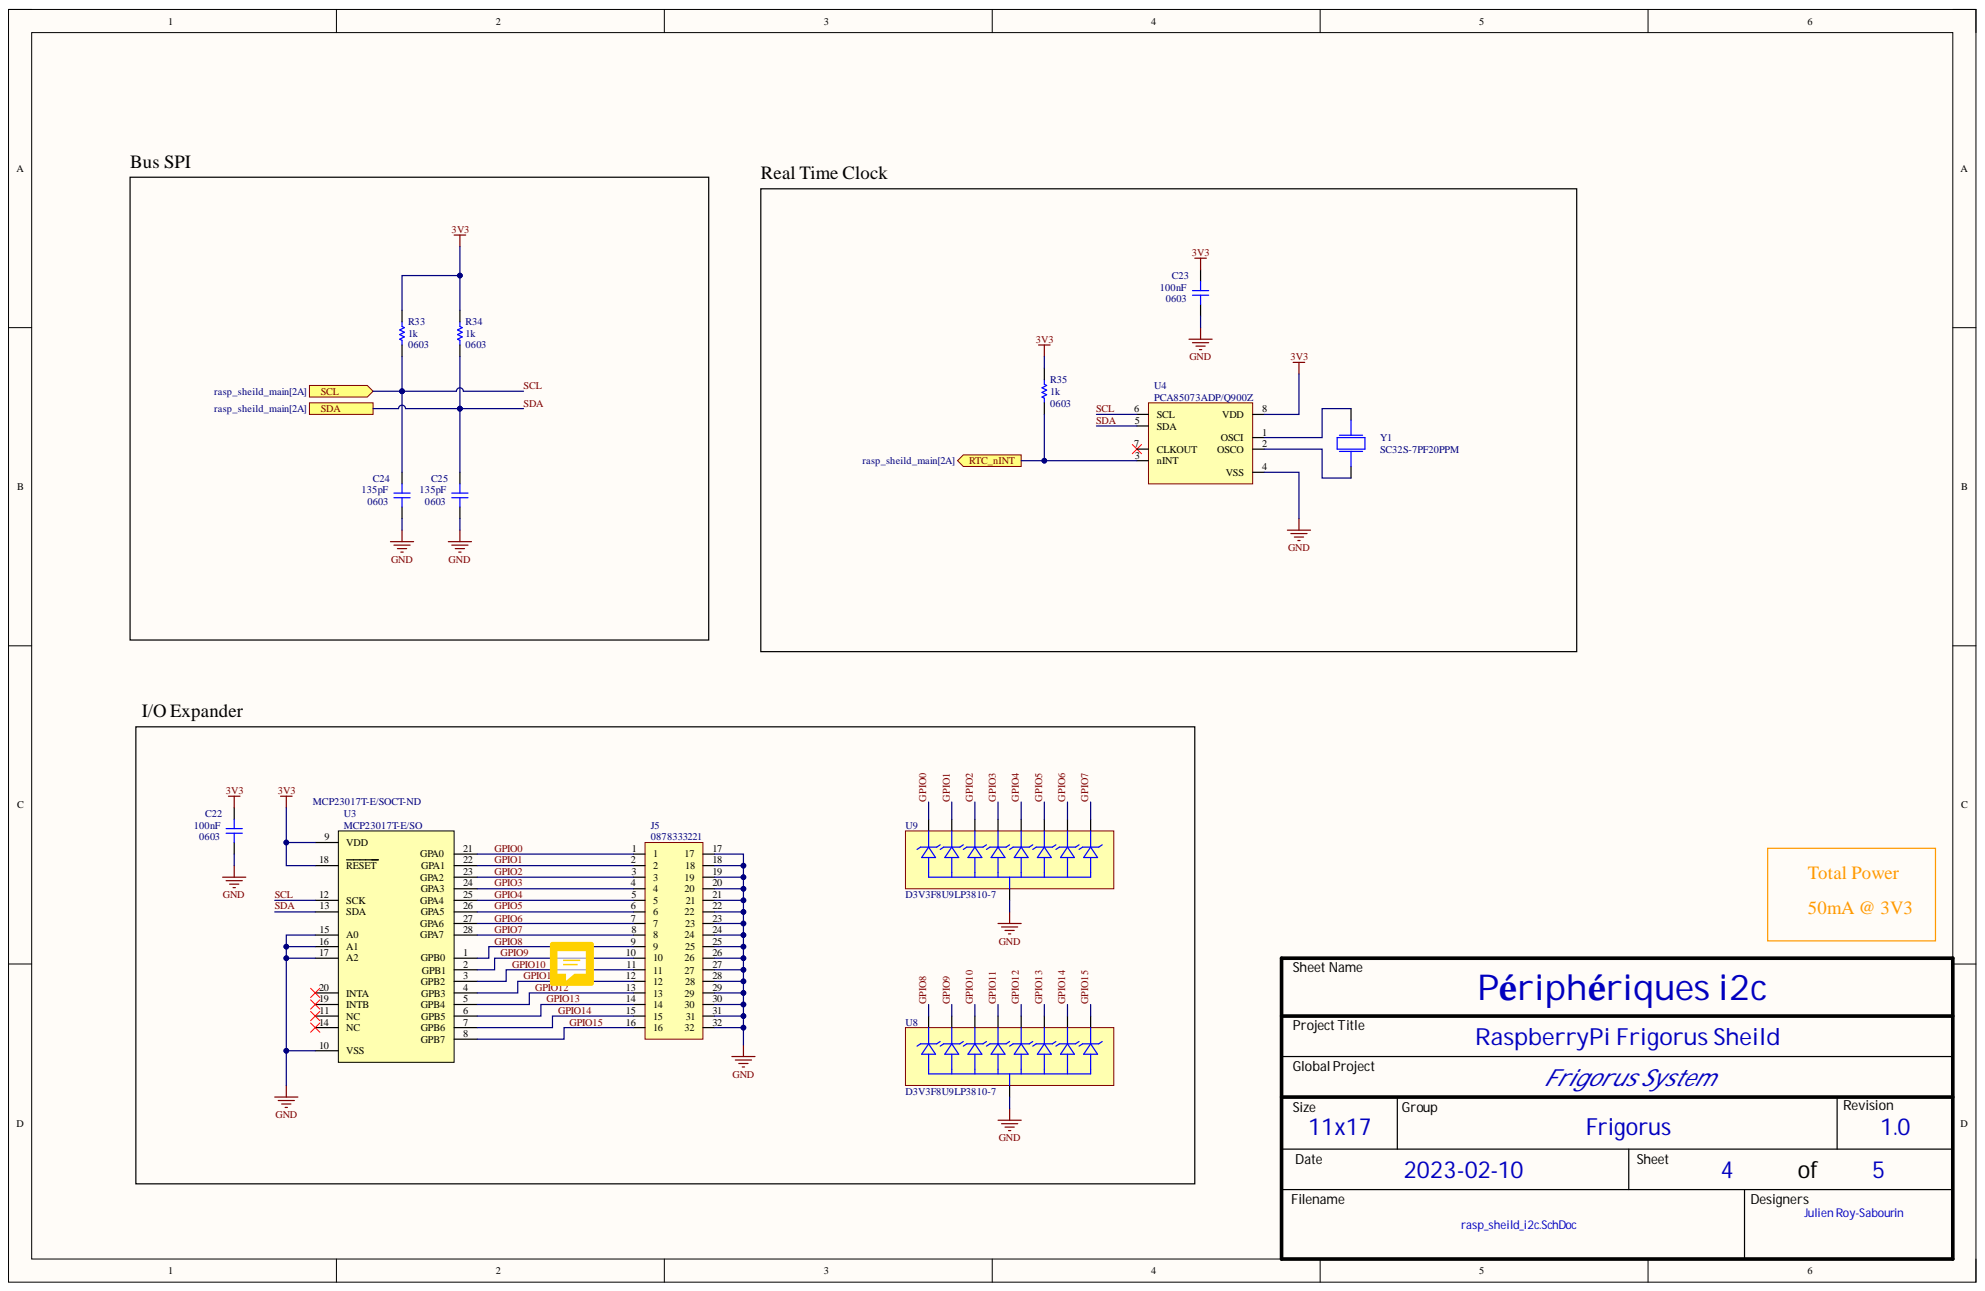
[picture p12: page 4]

Size 11x17 | Group Frigorus | Revision 1.0

Date 2023-02-10 | Sheet of 4 5

Filename rasp_sheild_i2c.SchDoc | Designers Julien Roy-Sabourin

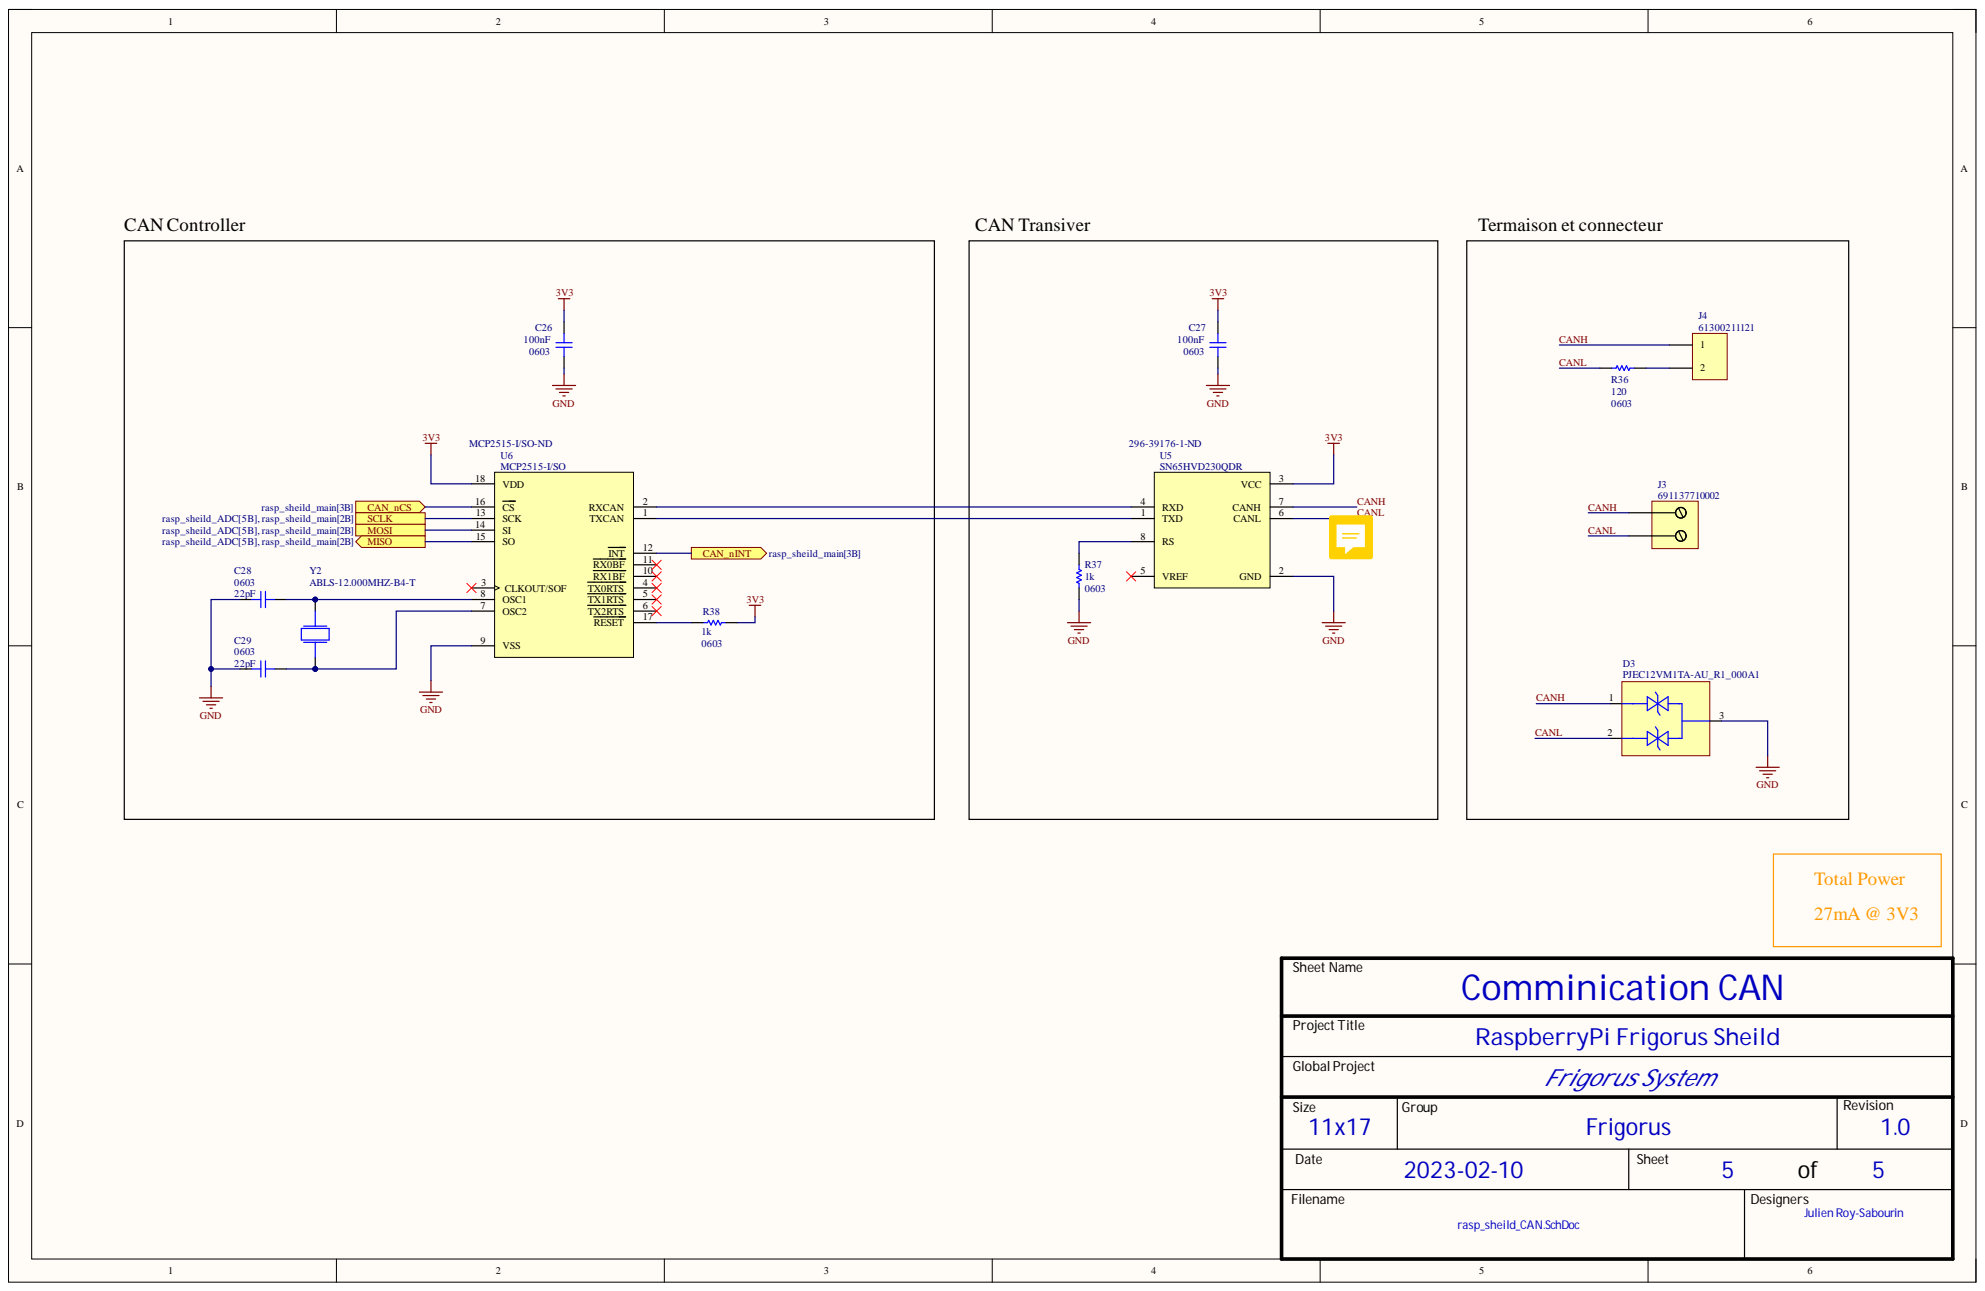
[picture p13: page 5]

S i z e 1 1x1 7 | Gr ou p Frigoru s | Rev ision 1 . 0

Date Filename 2 0 2 3-0 2 -1 0 | S heet of 5 5

r a sp_she i ld_CA N . Sch D oc | Desi gner s Jul i en R oy-Sabo u r i n
