ZacharyTurcotte/PMC-FrigorUS/(list of files, drawings)

Other design files:
PCB/rasp_sheild.PrjPcb
PCB/rasp_sheild_ADC.SchDoc
PCB/rasp_sheild_CAN.SchDoc
PCB/rasp_sheild_i2c.SchDoc
PCB/rasp_sheild_main.SchDoc
PCB/rasp_sheild_title.SchDoc
