ZacharyTurcotte/PMC-FrigorUS/(commit log)

2023-02-06 CAN on arduino with MCP2515
2023-02-07 calcul de temperature fini avec stein... méthode
2023-02-08 can node on the arduino
    [test_frigo.csv]
2023-02-11 thermistance done
    [test_frigo.csv]
2023-03-06 fin thermistance et code de valid curve fitting
2023-03-08 fichier sur le Pi, driver ADC, thermistance, CAN
2023-03-13 Driver RTC, quelque modif a faire concernant le registre d'init et peut-être la conversion de bit a sec,min,etc.
2023-03-13 changement de vitesse d'acquisition et eq de thermistance
2023-04-05 update can bus
2023-04-05 heat pad sussy changes
2023-04-05 changement de formatage
2023-04-08 utilisation du uart sur le Pi
2023-04-08 update sur le uart
2023-04-13 Ajout du projet Altium
    [BOM-rasp_sheild.xlsx, BOM-rasp_sheildddd.xlsx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]
